lorenzogalli-dev/Reaction-Time-System/Arduino/AlgorithmRealTimeESP32/Data/block_starts_081026/plot_010815_aic_pick.jpeg

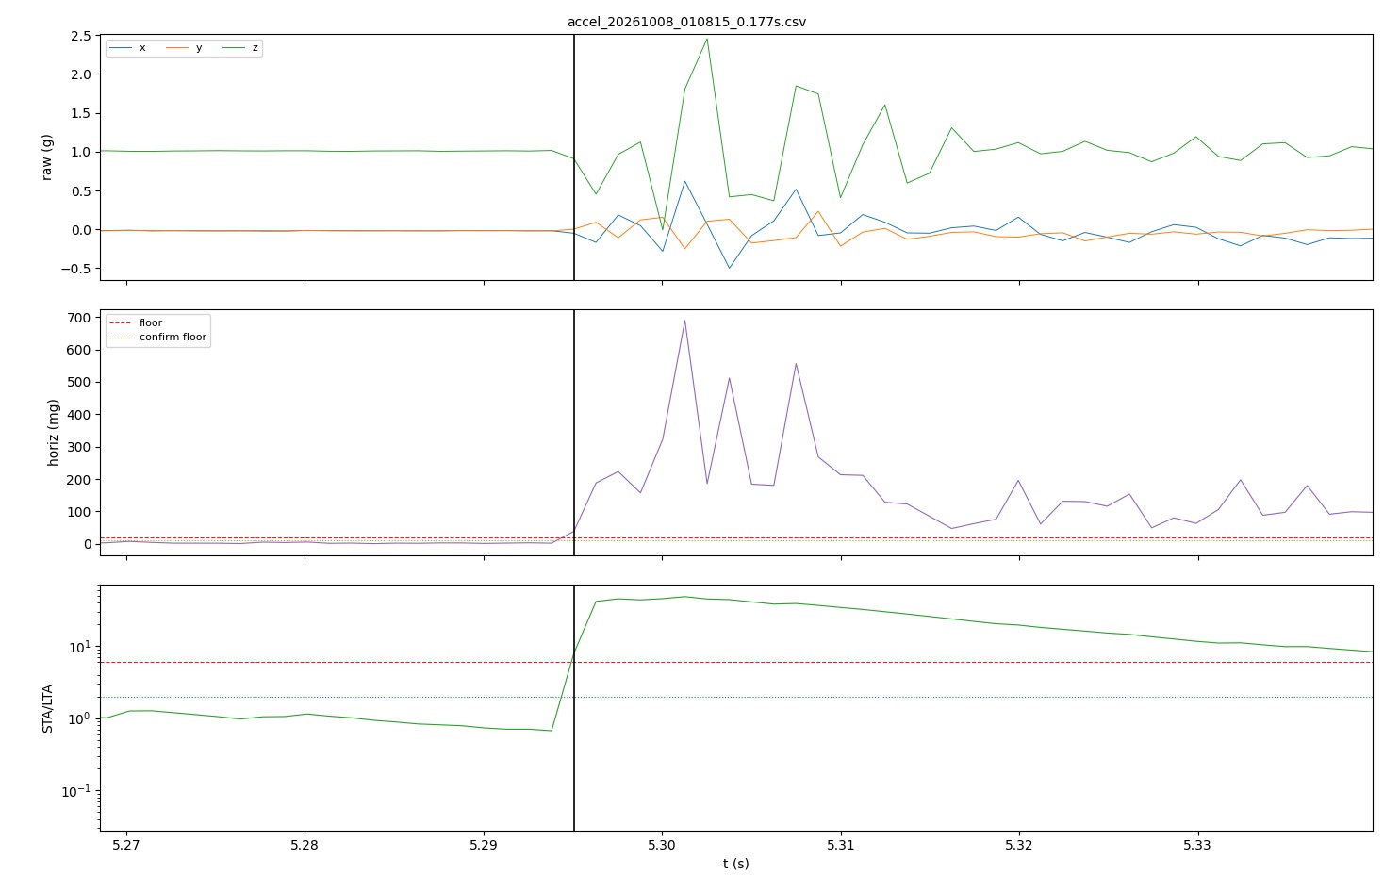
Arduino/AlgorithmRealTimeESP32/Data/block_starts_081026/plot_010815_aic_pick.jpeg
