lorenzogalli-dev/Reaction-Time-System/Arduino/AlgorithmRealTimeESP32/pcb/pcb_3d.jpeg

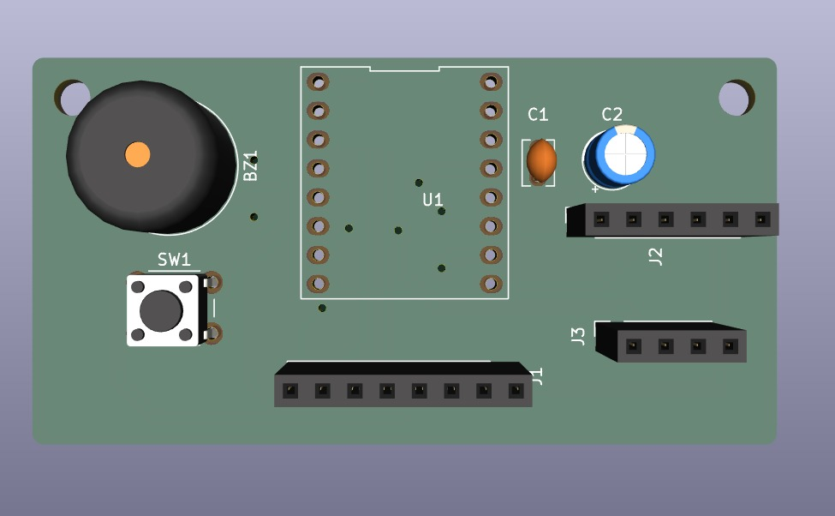
Arduino/AlgorithmRealTimeESP32/pcb/pcb_3d.jpeg
