lorenzogalli-dev/Reaction-Time-System/Arduino/AlgorithmRealTimeESP32/pcb/pcb_layout.jpeg

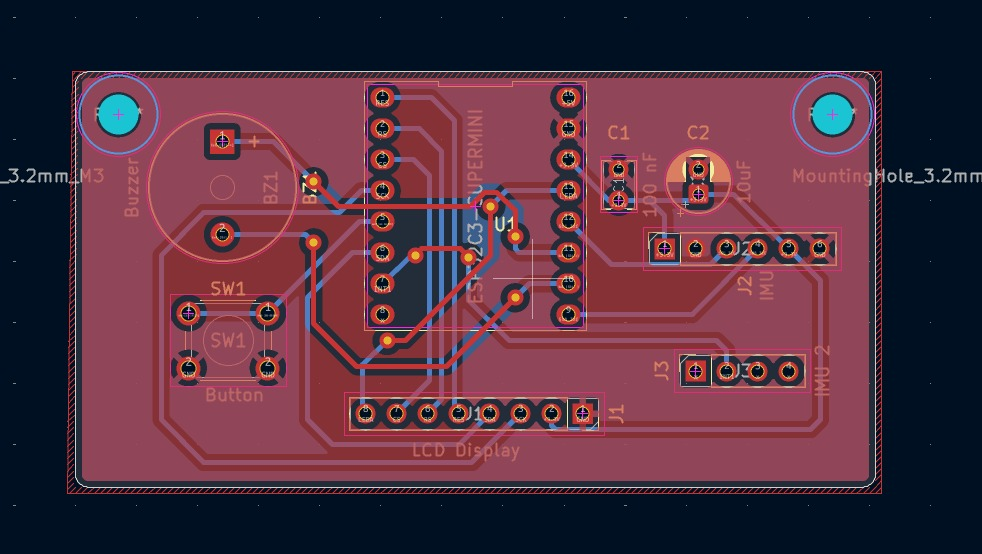
Arduino/AlgorithmRealTimeESP32/pcb/pcb_layout.jpeg
