lorenzogalli-dev/Reaction-Time-System/Arduino/AlgorithmRealTimeESP32/pcb/schematic.jpeg

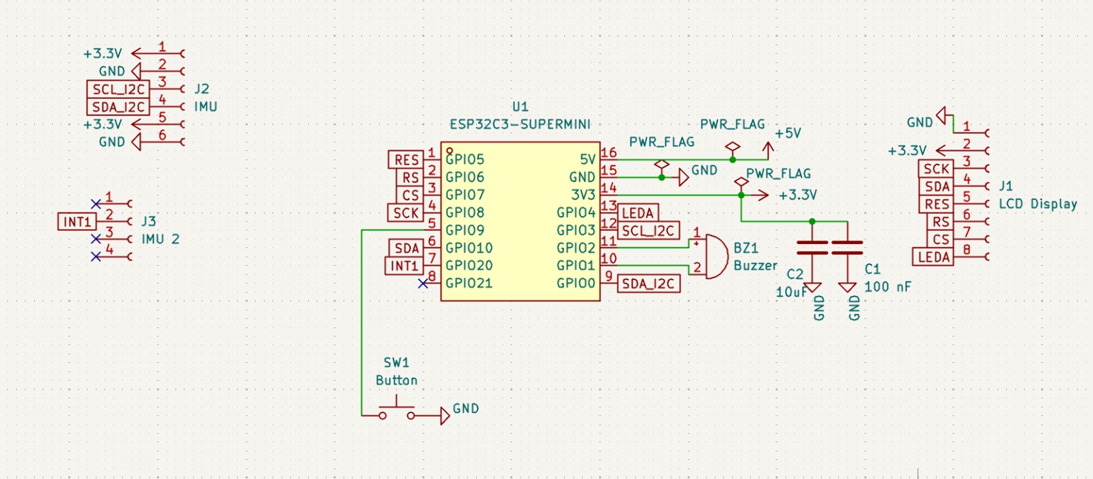
Arduino/AlgorithmRealTimeESP32/pcb/schematic.jpeg
