lorenzogalli-dev/Reaction-Time-System/Data/data_before_080926/accel_20260903_144609.png

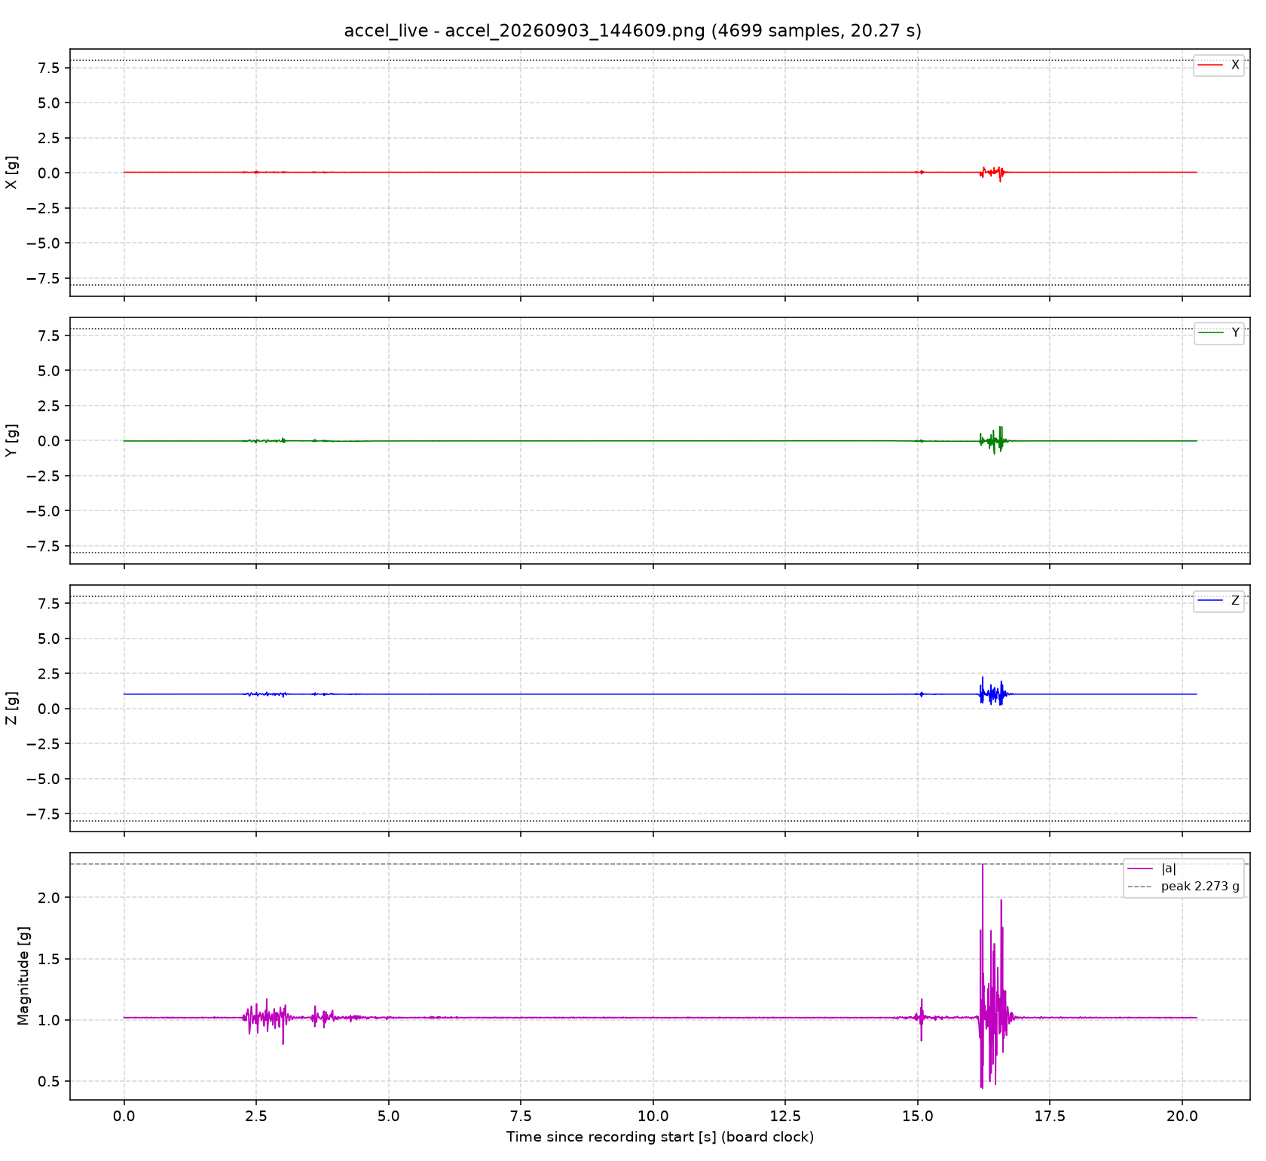
Data/data_before_080926/accel_20260903_144609.png
