lorenzogalli-dev/Reaction-Time-System/Data/data_before_080926/accel_20260907_160755.png

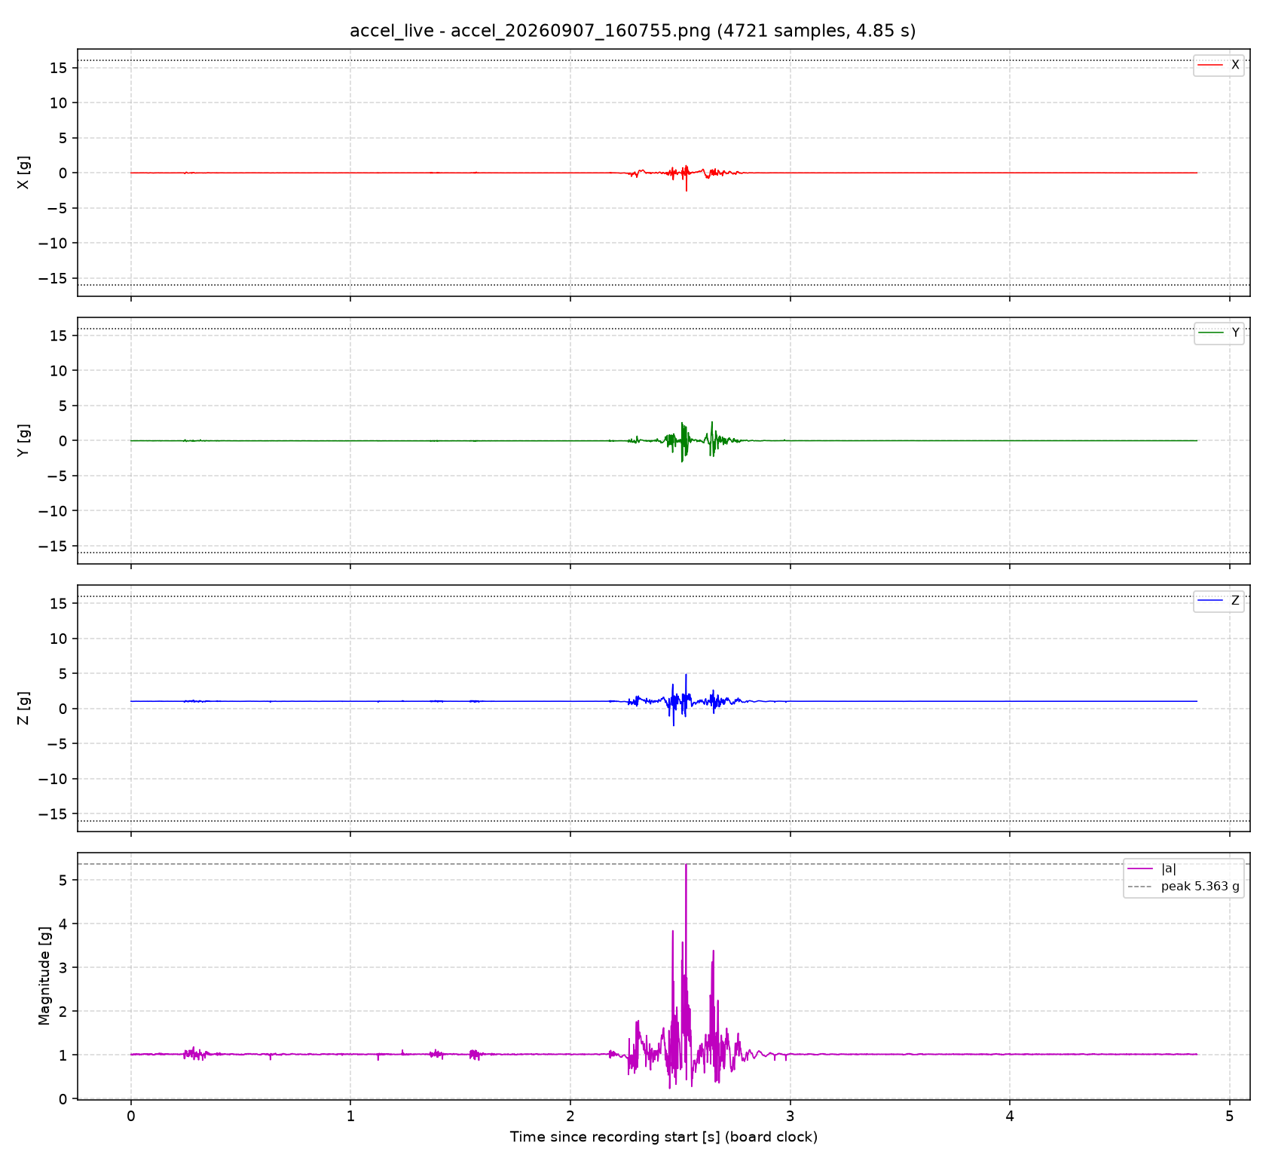
Data/data_before_080926/accel_20260907_160755.png
