lorenzogalli-dev/Reaction-Time-System/Data/data_before_080926/accel_20260908_164231.png

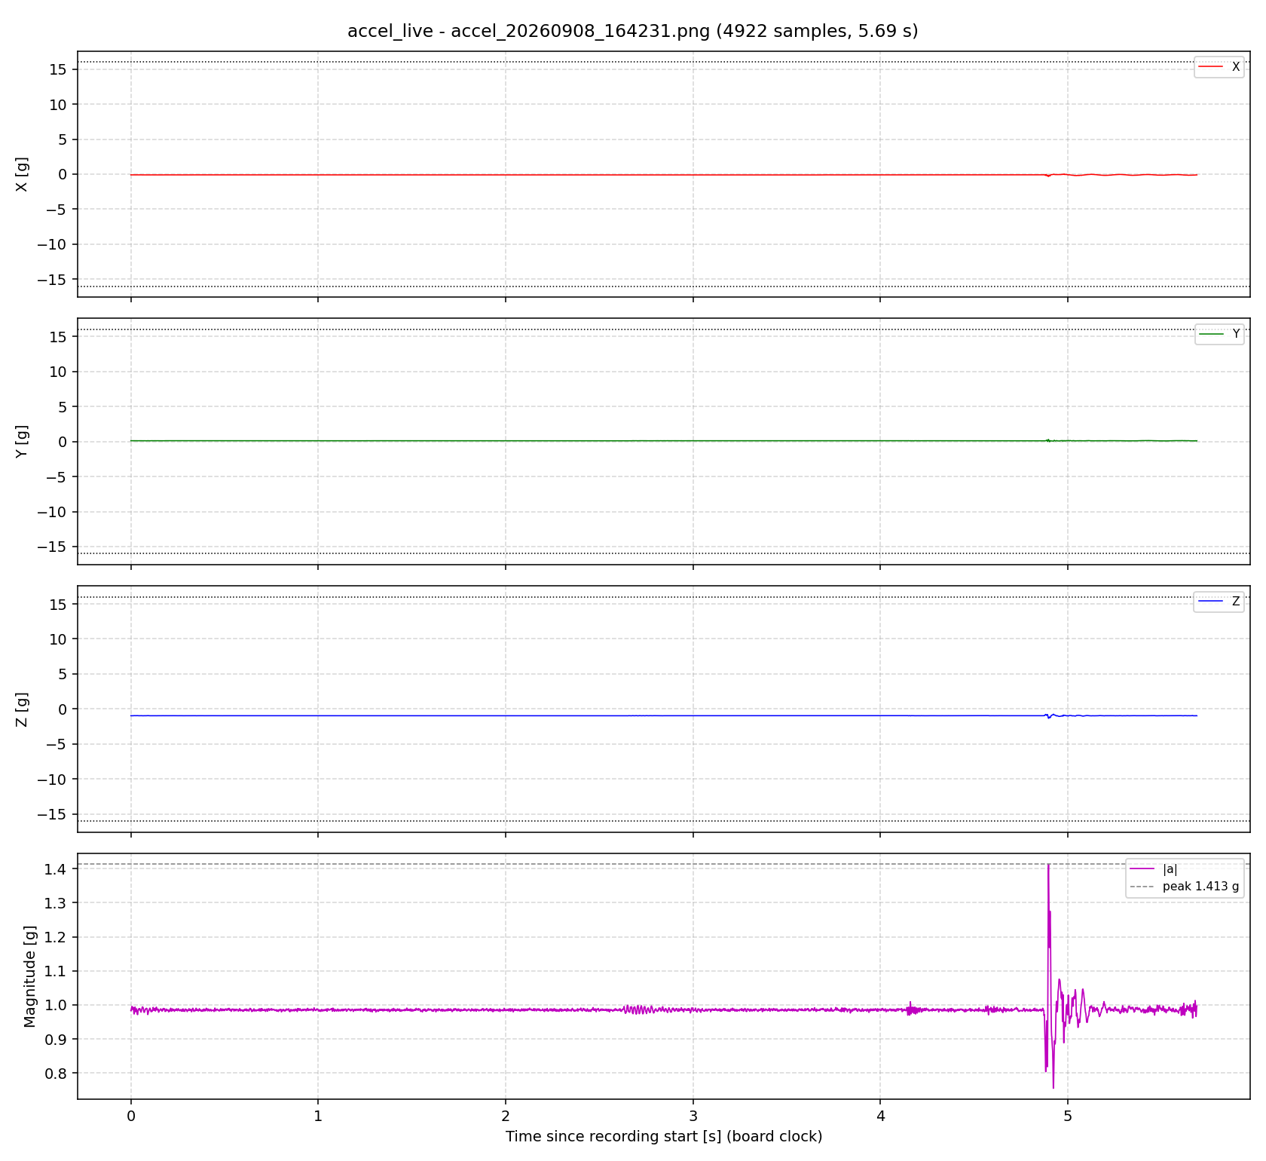
Data/data_before_080926/accel_20260908_164231.png
