lorenzogalli-dev/Reaction-Time-System/Docs/hardware/breadboard_xiao_button_buzzer_before_display.jpg

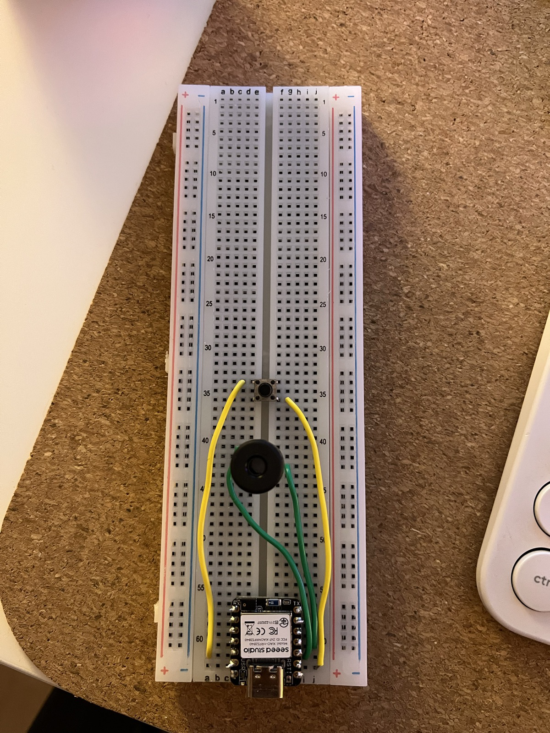
Docs/hardware/breadboard_xiao_button_buzzer_before_display.jpg
