lorenzogalli-dev/Reaction-Time-System/Docs/hardware/tft_177_st7735_back_pinout.jpg

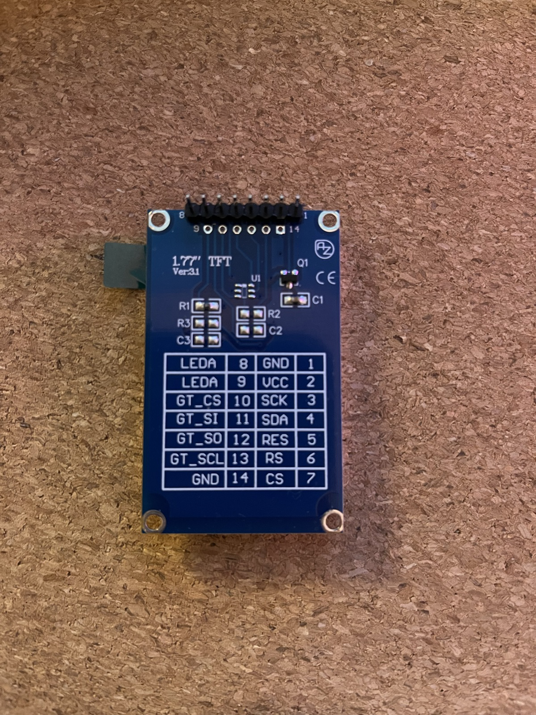
Docs/hardware/tft_177_st7735_back_pinout.jpg
