lorenzogalli-dev/Reaction-Time-System/Docs/hardware/tft_177_st7735_front.jpg

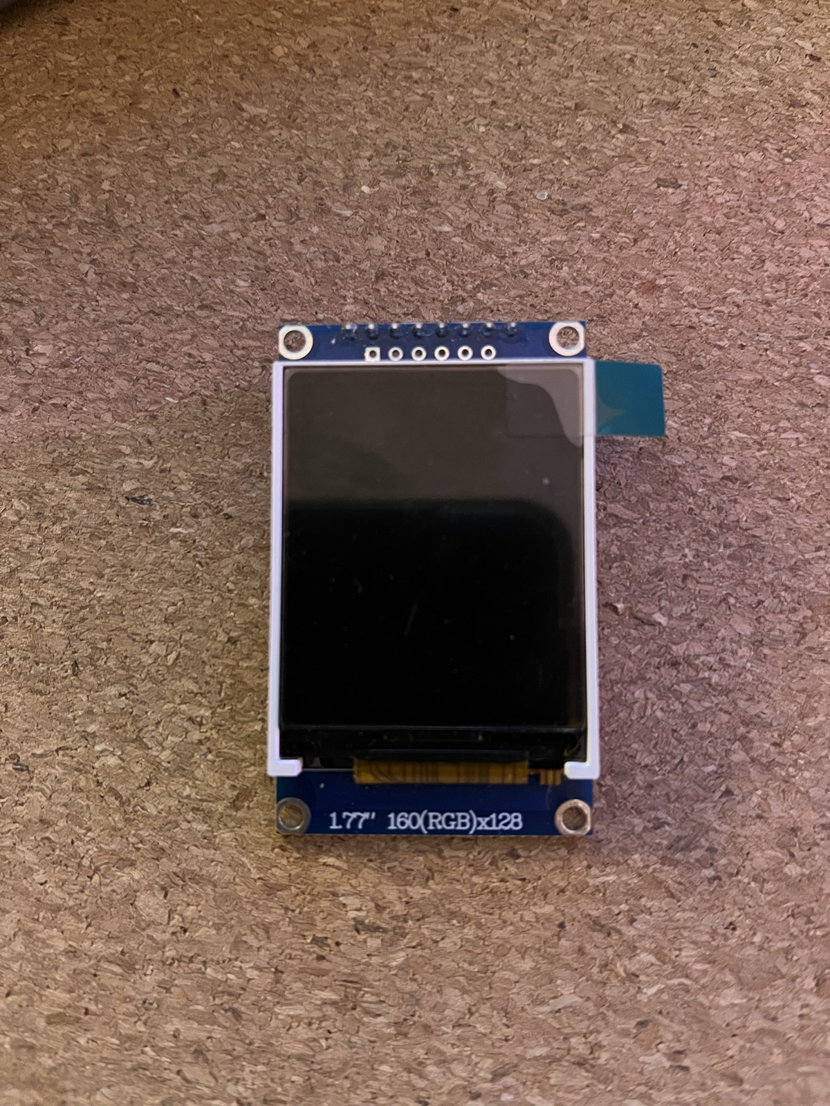
Docs/hardware/tft_177_st7735_front.jpg
