lorenzogalli-dev/Reaction-Time-System/Docs/reaction_time_diagram.png

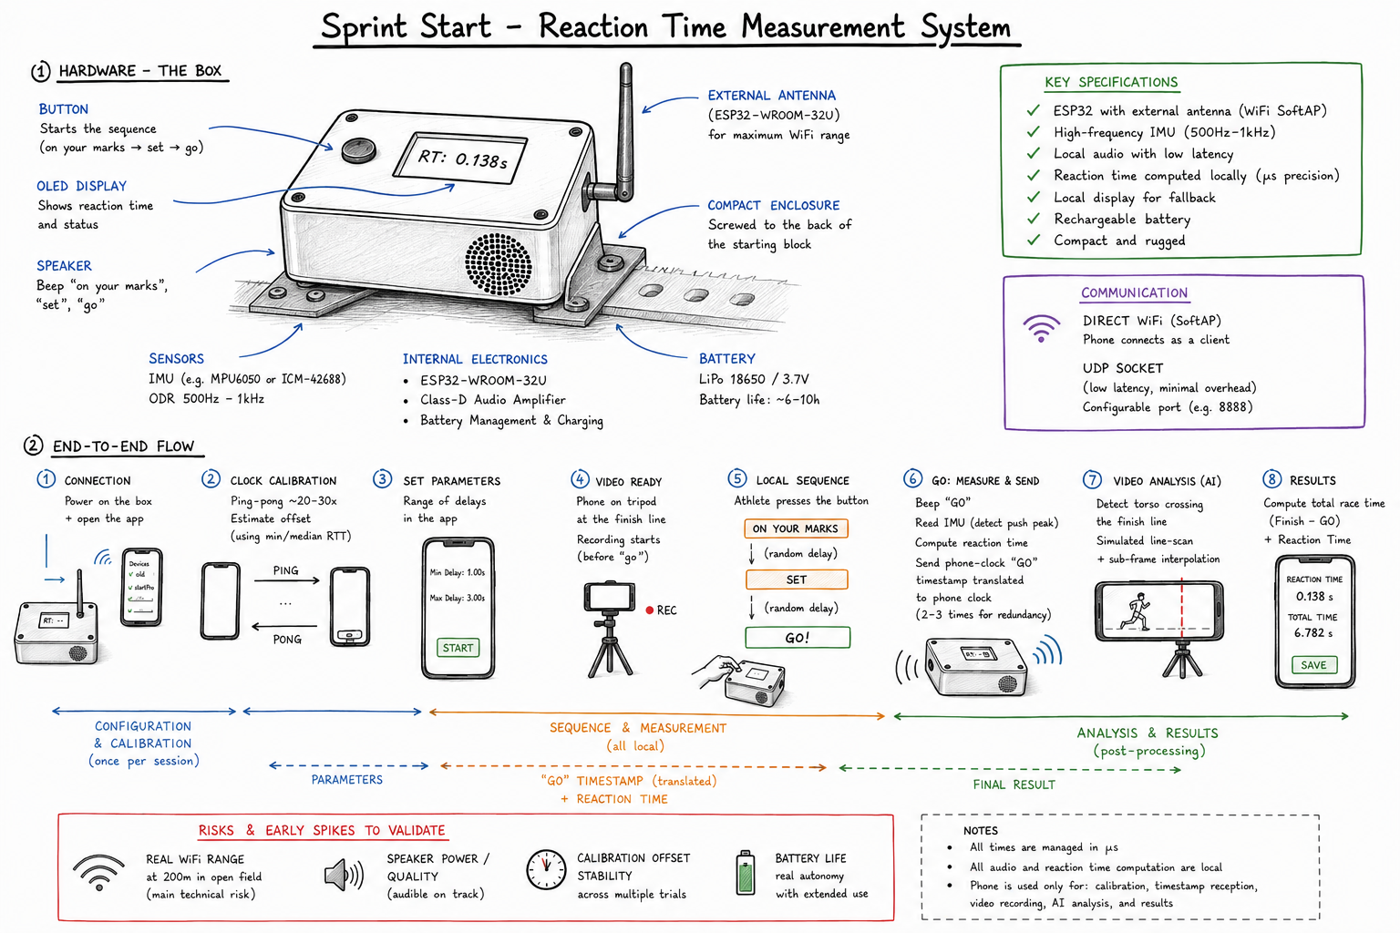
Docs/reaction_time_diagram.png
