lorenzogalli-dev/Reaction-Time-System/Docs/reaction_time_diagram_v2.png

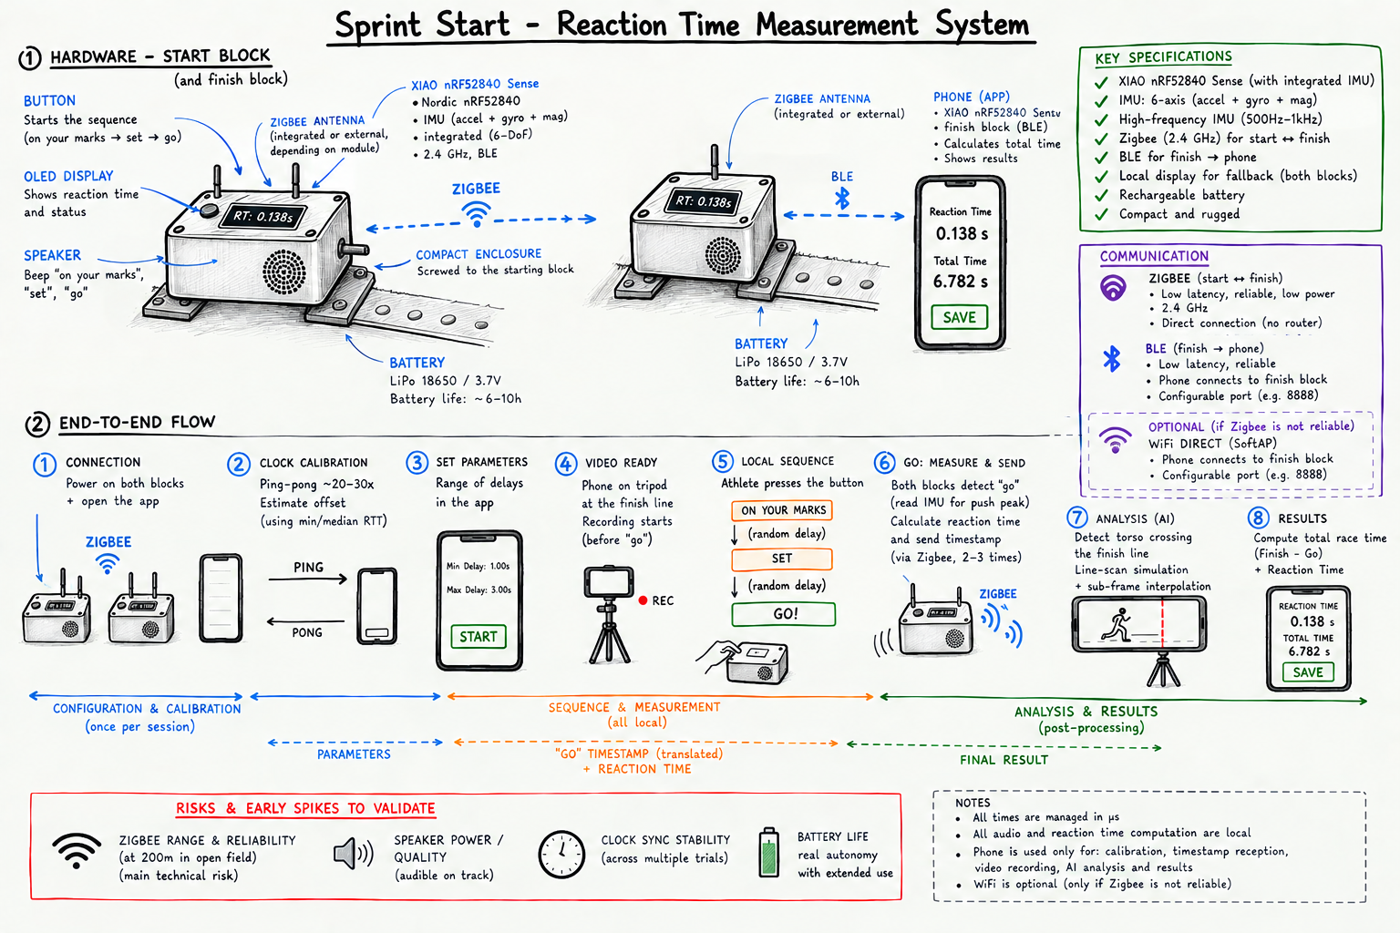
Docs/reaction_time_diagram_v2.png
