lorenzogalli-dev/Reaction-Time-System/prostart/assets/images/finish.png

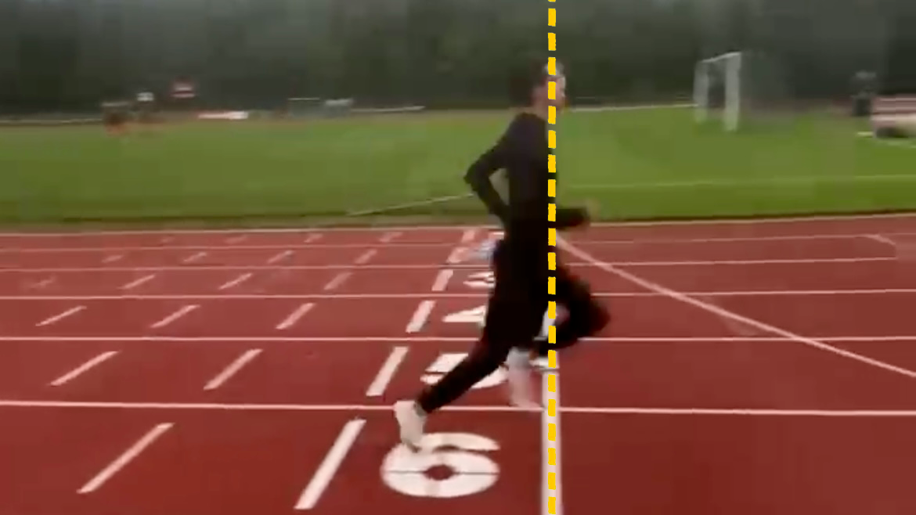
prostart/assets/images/finish.png
