lorenzogalli-dev/Reaction-Time-System/prostart/Prostart Media/56716fc30de684aaa0c9b7536a3d883a.jpg

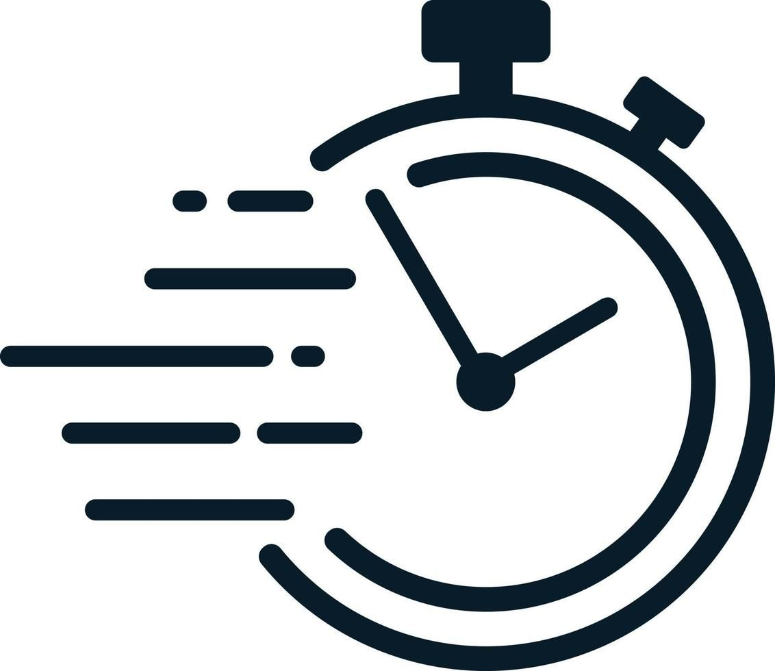
prostart/Prostart Media/56716fc30de684aaa0c9b7536a3d883a.jpg
