lorenzogalli-dev/Reaction-Time-System/prostart/Prostart Media/Box.png

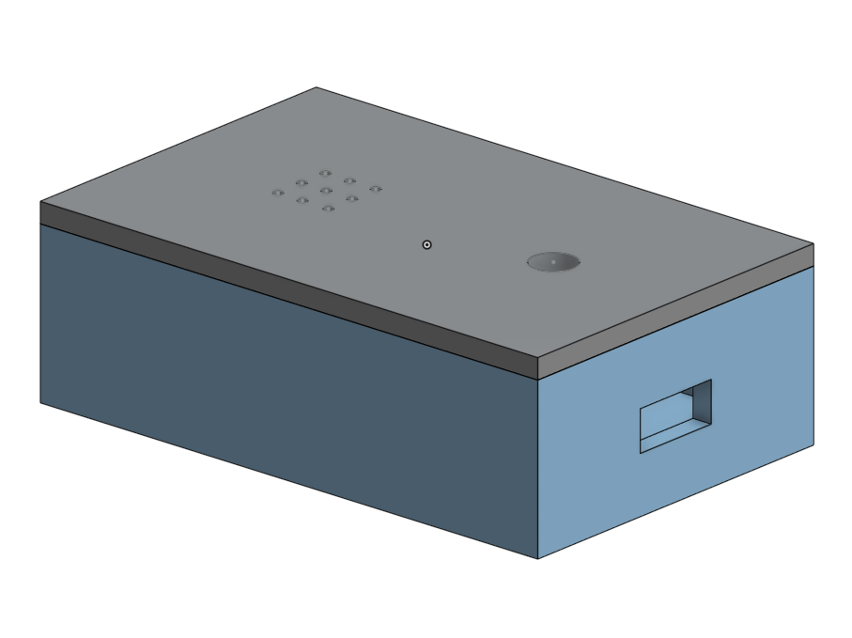
prostart/Prostart Media/Box.png
