lorenzogalli-dev/Reaction-Time-System/prostart/Prostart Media/getstarted.png

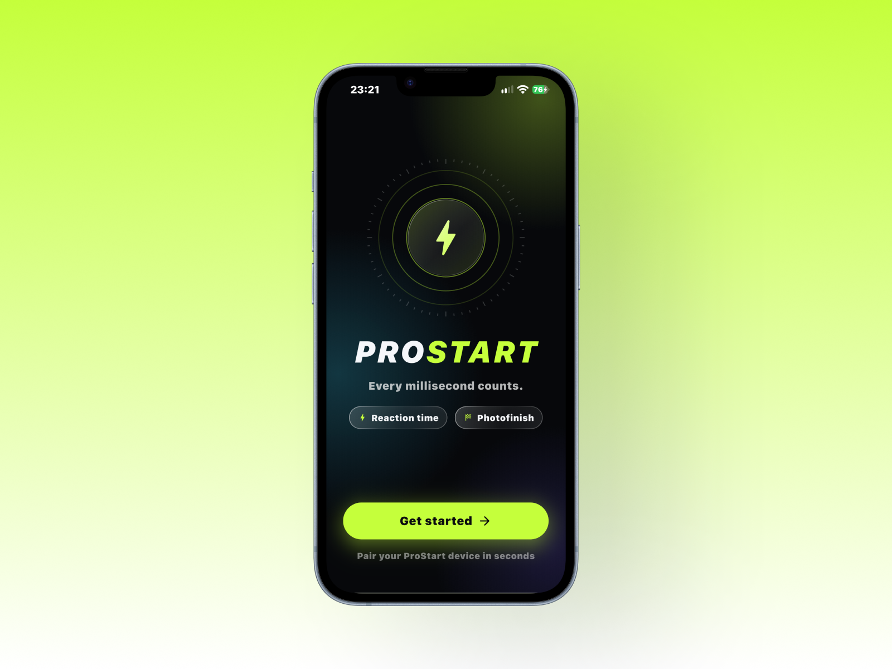
prostart/Prostart Media/getstarted.png
