lorenzogalli-dev/Reaction-Time-System/prostart/Prostart Media/getstartedtransparent.png

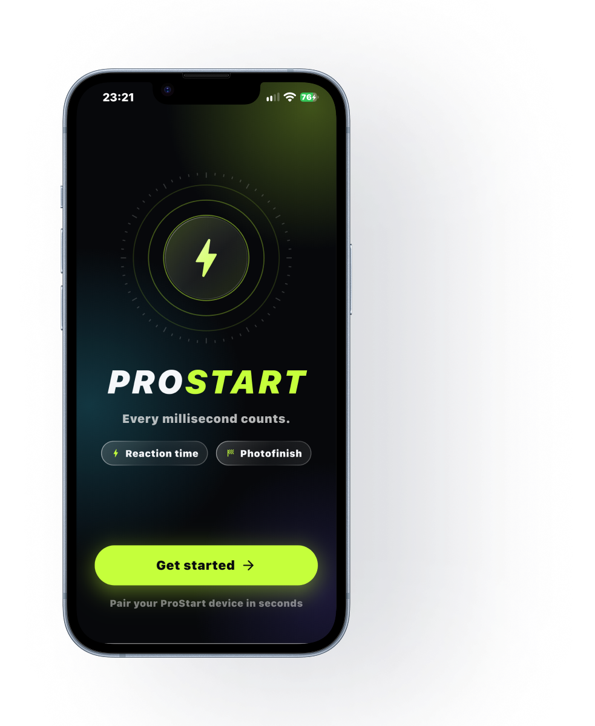
prostart/Prostart Media/getstartedtransparent.png
