lorenzogalli-dev/Reaction-Time-System/prostart/Prostart Media/homepagetransparent.png

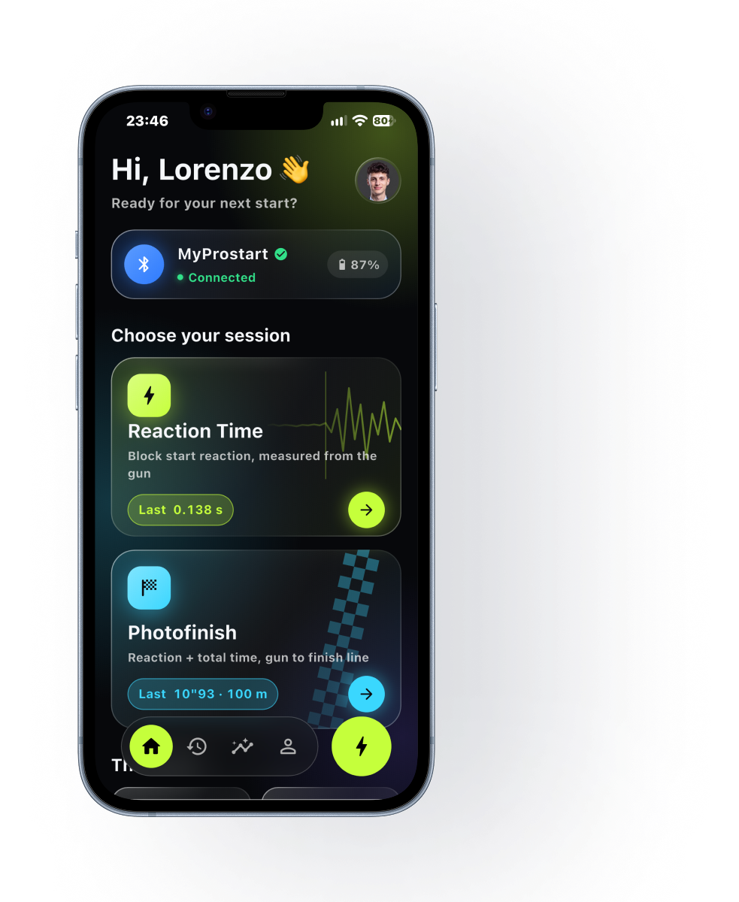
prostart/Prostart Media/homepagetransparent.png
