lorenzogalli-dev/Reaction-Time-System/prostart/Prostart Media/IMG_2231.jpg

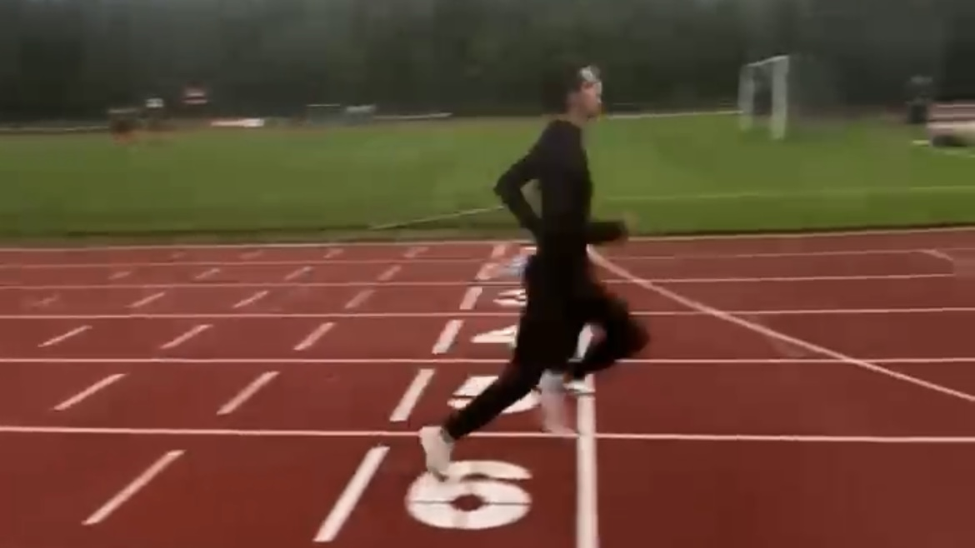
prostart/Prostart Media/IMG_2231.jpg
