lorenzogalli-dev/Reaction-Time-System/prostart/Prostart Media/IMG_2232.PNG

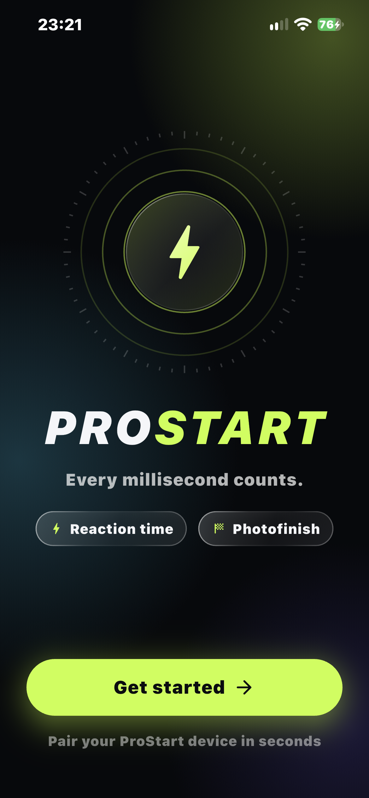
prostart/Prostart Media/IMG_2232.PNG
