lorenzogalli-dev/Reaction-Time-System/prostart/Prostart Media/IMG_2237.PNG

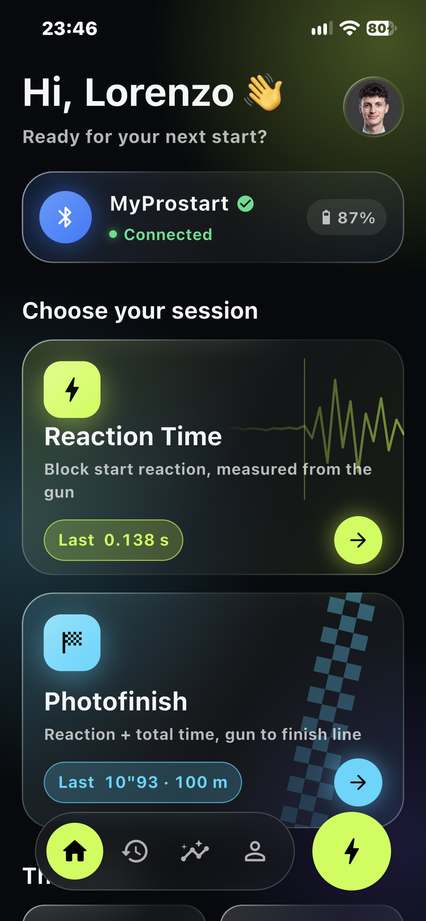
prostart/Prostart Media/IMG_2237.PNG
