lorenzogalli-dev/Reaction-Time-System/prostart/Prostart Media/IMG_2238.PNG

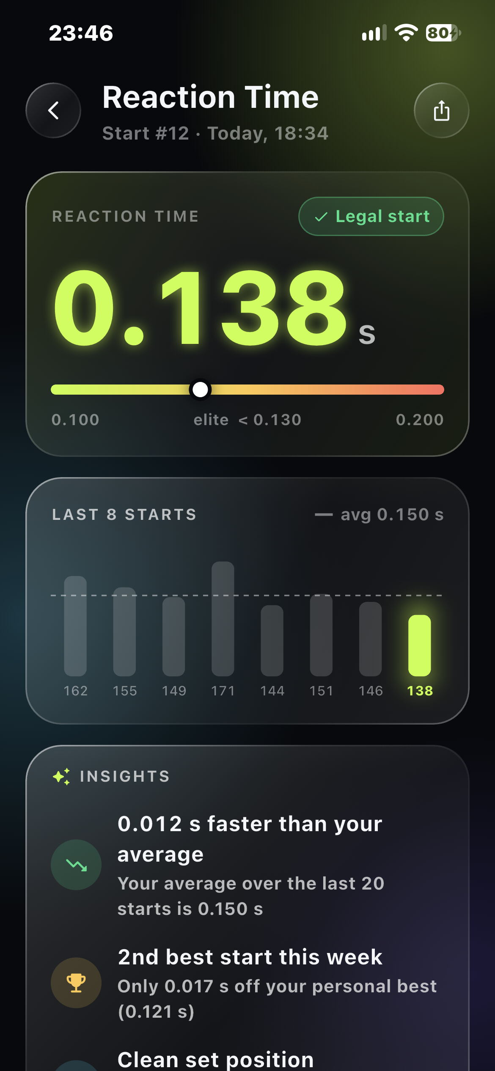
prostart/Prostart Media/IMG_2238.PNG
