lorenzogalli-dev/Reaction-Time-System/prostart/Prostart Media/IMG_2239.PNG

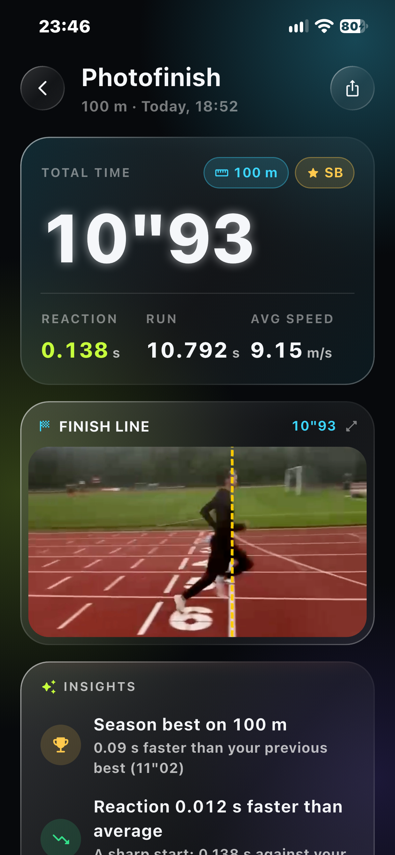
prostart/Prostart Media/IMG_2239.PNG
