lorenzogalli-dev/Reaction-Time-System/prostart/Prostart Media/pages.png

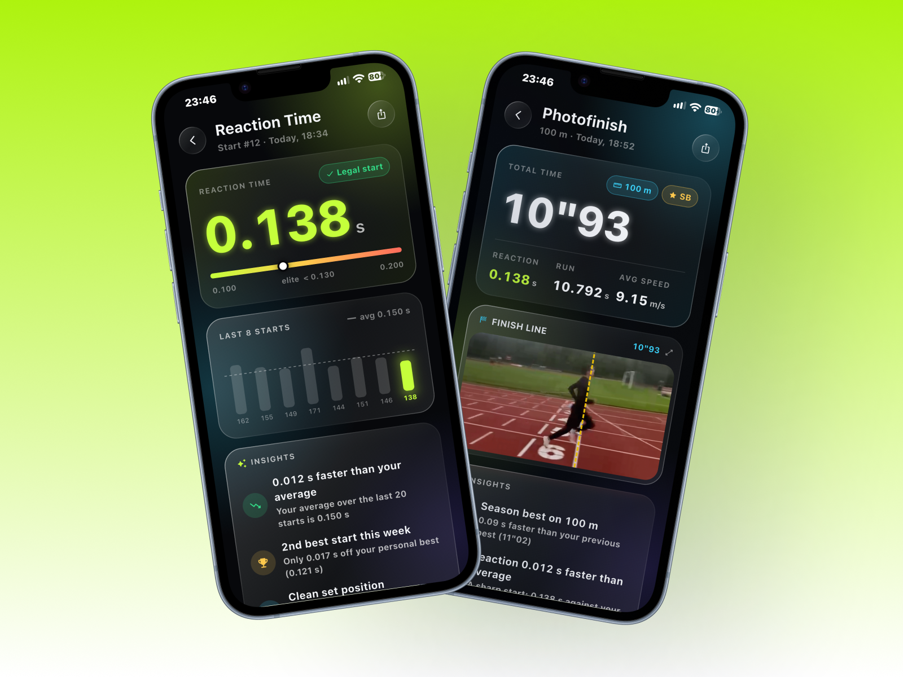
prostart/Prostart Media/pages.png
