lorenzogalli-dev/Reaction-Time-System/prostart/Prostart Media/stopwatch-2.png

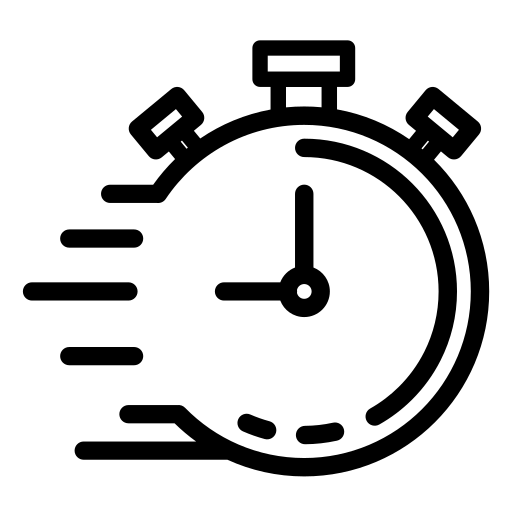
prostart/Prostart Media/stopwatch-2.png
