lorenzogalli-dev/Reaction-Time-System/prostart/Prostart Media/timer.png

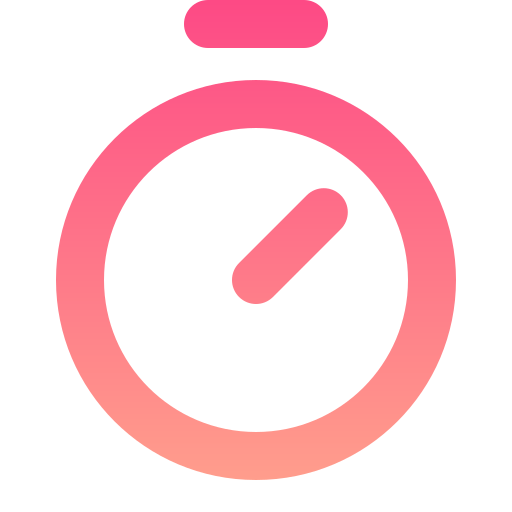
prostart/Prostart Media/timer.png
