lorenzogalli-dev/Reaction-Time-System/Arduino/WifiFieldTest/measurements/20260922/01_rssi-broken.csv

iso | ms | ev | dist | rssi | off | rtt | seq | golat
2026-09-22T12:48:45.410Z | 1790081325409.0 | ping | 0 | 0 | -1790081214054.607 | 4380.00
2026-09-22T12:48:45.410Z | 1790081325409.0 | ping | 0 | 0 | -1790081214054.607 | 4127.00
2026-09-22T12:48:45.410Z | 1790081325409.0 | ping | 0 | 0 | -1790081214054.607 | 3875.00
2026-09-22T12:48:45.410Z | 1790081325409.0 | ping | 0 | 0 | -1790081214054.607 | 3623.00
2026-09-22T12:48:45.410Z | 1790081325409.0 | ping | 0 | 0 | -1790081214054.607 | 3371.00
2026-09-22T12:48:45.410Z | 1790081325409.0 | ping | 0 | 0 | -1790081214054.607 | 3119.00
2026-09-22T12:48:45.410Z | 1790081325409.0 | ping | 0 | 0 | -1790081214054.607 | 2867.00
2026-09-22T12:48:45.493Z | 1790081325492.0 | ping | 0 | 0 | -1790081214054.607 | 10.00
2026-09-22T12:48:45.800Z | 1790081325799.0 | ping | 0 | 0 | -1790081214054.607 | 65.00
2026-09-22T12:48:45.994Z | 1790081325993.0 | ping | 0 | 0 | -1790081214054.607 | 7.00
2026-09-22T12:48:46.022Z | 1790081326021.0 | go | 0 | 0 | -1790081214054.607 |  | 22 | 3.92
2026-09-22T12:48:48.030Z | 1790081328029.0 | ping | 0 | 0 | -1790081214054.607 | 1791.00
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
