lorenzogalli-dev/Reaction-Time-System/Arduino/WifiFieldTest/measurements/20260922/02_short-run-30m.csv

iso | ms | ev | dist | rssi | off | jit | rtt | sent | got | lost | seq | golat
2026-09-22T12:59:45.753Z | 1790081985753.0 | ping | 0 | -48 | -1790081927283.379 | 4.50 | 9.00 | 1 | 1 | 0
2026-09-22T12:59:46.031Z | 1790081986031.0 | ping | 0 | -48 | -1790081927283.379 | 4.50 | 34.00 | 2 | 2 | 0
2026-09-22T12:59:46.271Z | 1790081986271.0 | ping | 0 | -49 | -1790081927283.379 | 4.50 | 22.00 | 3 | 3 | 0
2026-09-22T12:59:46.509Z | 1790081986508.0 | ping | 0 | -49 | -1790081927285.463 | 4.00 | 8.00 | 4 | 4 | 0
2026-09-22T12:59:46.762Z | 1790081986761.0 | ping | 0 | -51 | -1790081927285.463 | 4.00 | 9.00 | 5 | 5 | 0
2026-09-22T12:59:47.016Z | 1790081987015.0 | ping | 0 | -52 | -1790081927285.463 | 4.00 | 11.00 | 6 | 6 | 0
2026-09-22T12:59:47.282Z | 1790081987282.0 | ping | 0 | -53 | -1790081927285.463 | 4.00 | 26.00 | 7 | 7 | 0
2026-09-22T12:59:47.289Z | 1790081987289.0 | go | 0 | -53 | -1790081927285.463 | 4.00 |  | 7 | 7 | 0 | 12 | 2.04
2026-09-22T12:59:47.520Z | 1790081987520.0 | ping | 0 | -55 | -1790081927285.463 | 4.00 | 12.00 | 8 | 8 | 0
2026-09-22T12:59:47.775Z | 1790081987775.0 | ping | 0 | -56 | -1790081927285.463 | 4.00 | 14.00 | 9 | 9 | 0
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
