lorenzogalli-dev/Reaction-Time-System/Arduino/WifiFieldTest/measurements/20260922/03_full-run-70m.csv

iso | ms | ev | dist | rssi | off | jit | rtt | sent | got | lost | seq | golat
2026-09-22T13:00:59.772Z | 1790082059772.0 | ping | 0 | -55 | -1790081927282.724 | 4.00 | 8.00 | 1 | 1 | 0
2026-09-22T13:01:00.033Z | 1790082060033.0 | ping | 0 | -55 | -1790081927282.724 | 4.00 | 17.00 | 2 | 2 | 0
2026-09-22T13:01:00.282Z | 1790082060282.0 | ping | 0 | -55 | -1790081927282.724 | 4.00 | 13.00 | 3 | 3 | 0
2026-09-22T13:01:00.526Z | 1790082060526.0 | ping | 0 | -55 | -1790081927283.422 | 2.50 | 5.00 | 4 | 4 | 0
2026-09-22T13:01:00.780Z | 1790082060780.0 | ping | 0 | -55 | -1790081927283.422 | 2.50 | 7.00 | 5 | 5 | 0
2026-09-22T13:01:01.030Z | 1790082061030.0 | ping | 0 | -55 | -1790081927283.422 | 2.50 | 5.00 | 6 | 6 | 0
2026-09-22T13:01:01.290Z | 1790082061290.0 | ping | 0 | -55 | -1790081927283.422 | 2.50 | 13.00 | 7 | 7 | 0
2026-09-22T13:01:01.535Z | 1790082061535.0 | ping | 0 | -55 | -1790081927283.422 | 2.50 | 6.00 | 8 | 8 | 0
2026-09-22T13:01:01.787Z | 1790082061787.0 | ping | 0 | -54 | -1790081927283.422 | 2.50 | 6.00 | 9 | 9 | 0
2026-09-22T13:01:02.056Z | 1790082062056.0 | ping | 0 | -55 | -1790081927283.422 | 2.50 | 24.00 | 10 | 10 | 0
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
