lorenzogalli-dev/Reaction-Time-System/Arduino/EspNowLrTest/measurements/20260929/01_bench-1m_A.csv

# EspNowLrTest role=A port=/dev/cu.usbmodem101 started=2026-09-29T12:18:38.384802
# host_s | <board line> host_s = seconds since the logger started
0.224 | rst:0x15 (USB_UART_CHIP_RESET) | boot:0xd (SPI_FAST_FLASH_BOOT)
0.224 | Saved PC:0x4038b48a
0.224 | SPIWP:0xee
0.224 | mode:DIO | clock div:1
0.224 | load:0x3fcd5820 | len:0x110c
0.224 | load:0x403cbf10 | len:0xb54
0.224 | load:0x403ce710 | len:0x2f9c
0.224 | entry 0x403cbf10
0.631 | # | EspNowLrTest pronto
0.631 | I | A | 64:E8:33:88:3A:6C | 1 | noap | 20.0
0.631 | I | A | 64:E8:33:88:3A:6C | 1 | noap | 20.0
0.631 | S | 360 | 0 | 0 | 0
0.631 | E | 371 | 0 | 0 | 10571 | 53122695 | -60 | -60
0.631 | E | 374 | 1 | 0 | 13991 | 53124593 | -61 | -59
0.631 | E | 385 | 2 | 0 | 24516 | 53129444 | -61 | -60
0.631 | E | 391 | 3 | 0 | 31158 | 53129944 | -59 | -59
0.631 | E | 398 | 4 | 0 | 37793 | 53133275 | -60 | -59
0.631 | E | 405 | 5 | 0 | 44527 | 53136547 | -60 | -60
0.631 | K | 411 | 0 | 0 | 1 | 51218
0.631 | E | 418 | 6 | 0 | 56997 | 53142852 | -60 | -59
0.631 | E | 421 | 7 | 0 | 11315 | 53123149 | -60 | -59
0.834 | E | 472 | 8 | 0 | 12278 | 53126349 | -60 | -59
0.834 | E | 518 | 9 | 0 | 7682 | 53124028 | -60 | -58
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
