lorenzogalli-dev/Reaction-Time-System/Arduino/EspNowLrTest/measurements/20260929/02_walk-ceramic-antenna_A.csv

# EspNowLrTest role=A port=/dev/cu.usbmodem101 started=2026-09-29T12:51:03.555839
# host_s | <board line> host_s = seconds since the logger started
0.224 | rst:0x15 (USB_UART_CHIP_RESET) | boot:0xd (SPI_FAST_FLASH_BOOT)
0.224 | Saved PC:0x420b4b04
0.224 | SPIWP:0xee
0.224 | mode:DIO | clock div:1
0.224 | load:0x3fcd5820 | len:0x110c
0.224 | load:0x403cbf10 | len:0xb54
0.224 | load:0x403ce710 | len:0x2f9c
0.224 | entry 0x403cbf10
0.631 | # | EspNowLrTest pronto
0.631 | I | A | 64:E8:33:88:3A:6C | 1 | noap | 20.0
0.631 | I | A | 64:E8:33:88:3A:6C | 1 | noap | 20.0
0.631 | S | 362 | 0 | 0 | 0
0.631 | E | 370 | 0 | 0 | 8152 | 610071186 | -40 | -39
0.631 | E | 399 | 2 | 0 | 37328 | 610069891 | -41 | -40
0.631 | E | 403 | 3 | 0 | 40695 | 610071563 | -41 | -40
0.631 | E | 406 | 4 | 0 | 44109 | 610073167 | -42 | -41
0.631 | E | 409 | 5 | 0 | 47442 | 610074813 | -41 | -42
0.631 | K | 413 | 0 | 0 | 1 | 50912
0.631 | E | 420 | 7 | 0 | 8678 | 610071544 | -39 | -40
0.833 | E | 471 | 8 | 0 | 8964 | 610071594 | -40 | -39
0.833 | E | 519 | 9 | 0 | 7666 | 610070944 | -39 | -39
0.833 | E | 569 | 10 | 0 | 7871 | 610071077 | -40 | -40
0.833 | E | 620 | 11 | 0 | 8123 | 610071199 | -43 | -43
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
