lorenzogalli-dev/Reaction-Time-System/Arduino/EspNowLrTest/measurements/20260929/02_walk-ceramic-antenna_B.csv

# EspNowLrTest role=B port=COM15 started=2026-09-29T12:51:13.930742
# host_s | <board line> host_s = seconds since the logger started
0.234 | I | B | 64:E8:33:88:16:00 | 1 | noap | 20.0
0.234 | D | 619735 | 192 | 1 | -44 | 26
0.234 | D | 619785 | 193 | 1 | -44 | 26
0.234 | D | 619835 | 194 | 1 | -43 | 26
0.234 | D | 619885 | 195 | 1 | -43 | 26
0.234 | D | 619935 | 196 | 1 | -44 | 26
0.437 | D | 619985 | 197 | 1 | -45 | 26
0.437 | D | 620041 | 198 | 1 | -44 | 26
0.437 | D | 620088 | 199 | 1 | -45 | 26
0.437 | D | 620134 | 200 | 2 | -43 | 0
0.437 | T | 620135 | 2 | 1 | 2 | -44
0.640 | D | 620186 | 201 | 2 | -43 | 0
0.640 | D | 620234 | 202 | 2 | -44 | 0
0.640 | D | 620284 | 203 | 2 | -43 | 0
0.640 | D | 620335 | 204 | 2 | -43 | 0
0.843 | D | 620385 | 205 | 2 | -43 | 0
0.843 | D | 620434 | 206 | 2 | -44 | 0
0.843 | D | 620484 | 207 | 2 | -44 | 0
0.843 | D | 620534 | 208 | 2 | -44 | 0
1.046 | D | 620584 | 209 | 2 | -43 | 0
1.046 | D | 620634 | 210 | 2 | -43 | 0
1.046 | D | 620685 | 211 | 2 | -43 | 0
1.046 | D | 620734 | 212 | 2 | -44 | 0
1.250 | D | 620784 | 213 | 2 | -43 | 0
1.250 | D | 620834 | 214 | 2 | -45 | 0
1.250 | D | 620884 | 215 | 2 | -44 | 0
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
