lorenzogalli-dev/Reaction-Time-System/Arduino/EspNowLrTest/measurements/20260929/03_track-walk-31mm-wire_A.csv

# EspNowLrTest role=A port=/dev/cu.usbmodem101 started=2026-09-29T15:14:36.186668
# host_s | <board line> host_s = seconds since the logger started
0.223 | Build:Feb 7 2021
0.223 | rst:0x15 (USB_UART_CHIP_RESET) | boot:0xf (SPI_FAST_FLASH_BOOT)
0.223 | Saved PC:0x403870c6
0.223 | SPIWP:0xee
0.223 | mode:DIO | clock div:1
0.223 | load:0x3fcd5820 | len:0x110c
0.223 | load:0x403cbf10 | len:0xb54
0.223 | load:0x403ce710 | len:0x2f9c
0.223 | entry 0x403cbf10
0.627 | # | EspNowLrTest pronto
0.627 | I | A | 64:E8:33:88:3A:6C | 1 | noap | 20.0
0.627 | I | A | 64:E8:33:88:3A:6C | 1 | noap | 20.0
0.627 | S | 359 | 0 | 0 | 0
0.627 | E | 373 | 0 | 0 | 13606 | 219783039 | -40 | -40
0.627 | E | 379 | 1 | 0 | 20282 | 219783055 | -41 | -40
0.627 | E | 386 | 2 | 0 | 26982 | 219782974 | -41 | -43
0.627 | E | 393 | 3 | 0 | 33545 | 219786391 | -40 | -39
0.627 | E | 399 | 4 | 0 | 40224 | 219789697 | -40 | -40
0.627 | E | 406 | 5 | 0 | 47108 | 219792878 | -39 | -39
0.627 | E | 410 | 6 | 0 | 50616 | 219797790 | -40 | -41
0.828 | E | 466 | 8 | 0 | 7645 | 219785891 | -39 | -39
0.829 | E | 516 | 9 | 0 | 7677 | 219785898 | -40 | -39
0.829 | E | 566 | 10 | 0 | 7709 | 219785912 | -40 | -39
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
