lorenzogalli-dev/Reaction-Time-System/Arduino/EspNowLrTest/measurements/20260929/03_track-walk-31mm-wire_B.csv

# EspNowLrTest role=B port=COM15 started=2026-09-29T15:13:58.672149
# host_s | <board line> host_s = seconds since the logger started
0.234 | I | B | 64:E8:33:88:16:00 | 1 | noap | 20.0
0.234 | D | 181180 | 1000 | 1 | -47 | 26
0.234 | T | 181182 | 10 | 1 | 1 | -47
0.234 | D | 181230 | 1001 | 1 | -47 | 26
0.234 | D | 181280 | 1002 | 1 | -47 | 26
0.234 | D | 181330 | 1003 | 1 | -47 | 26
0.437 | D | 181380 | 1004 | 1 | -47 | 26
0.437 | D | 181430 | 1005 | 1 | -47 | 26
0.437 | D | 181480 | 1006 | 1 | -47 | 26
0.437 | D | 181530 | 1007 | 1 | -47 | 26
0.640 | D | 181580 | 1008 | 1 | -47 | 26
0.640 | D | 181630 | 1009 | 1 | -47 | 26
0.640 | D | 181680 | 1010 | 1 | -47 | 26
0.640 | D | 181730 | 1011 | 1 | -47 | 26
0.640 | D | 181780 | 1012 | 1 | -47 | 26
0.843 | D | 181830 | 1013 | 1 | -48 | 26
0.843 | D | 181880 | 1014 | 1 | -47 | 26
0.843 | D | 181930 | 1015 | 1 | -48 | 26
0.843 | D | 181980 | 1016 | 1 | -47 | 26
1.046 | D | 182030 | 1017 | 1 | -47 | 26
1.078 | D | 182080 | 1018 | 1 | -47 | 26
1.078 | D | 182130 | 1019 | 1 | -47 | 26
1.078 | D | 182180 | 1020 | 1 | -48 | 26
1.281 | D | 182230 | 1021 | 1 | -47 | 26
1.281 | D | 182280 | 1022 | 1 | -47 | 26
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
