lorenzogalli-dev/Reaction-Time-System/Arduino/EspNowLrTest/measurements/20260929/04_110m-crouched-phone-B2m_A.csv

# EspNowLrTest role=A port=/dev/cu.usbmodem101 started=2026-09-29T15:48:25.524223
# host_s | <board line> host_s = seconds since the logger started
0.224 | rst:0x15 (USB_UART_CHIP_RESET) | boot:0xf (SPI_FAST_FLASH_BOOT)
0.224 | Saved PC:0x40388006
0.224 | SPIWP:0xee
0.224 | mode:DIO | clock div:1
0.224 | load:0x3fcd5820 | len:0x110c
0.224 | load:0x403cbf10 | len:0xb54
0.224 | load:0x403ce710 | len:0x2f9c
0.224 | entry 0x403cbf10
0.627 | # | EspNowLrTest pronto
0.628 | I | A | 64:E8:33:88:3A:6C | 1 | noap | 20.0
0.628 | I | A | 64:E8:33:88:3A:6C | 1 | noap | 20.0
0.628 | S | 350 | 0 | 0 | 0
0.628 | E | 364 | 0 | 0 | 13441 | 123494063 | -32 | -32
0.628 | E | 367 | 1 | 0 | 17391 | 123495527 | -32 | -32
0.628 | E | 374 | 2 | 0 | 23615 | 123495705 | -32 | -32
0.628 | E | 381 | 3 | 0 | 30689 | 123502616 | -32 | -32
0.628 | E | 387 | 4 | 0 | 37037 | 123506152 | -31 | -33
0.628 | E | 395 | 5 | 0 | 43940 | 123509325 | -32 | -33
0.628 | E | 402 | 6 | 0 | 51633 | 123512140 | -33 | -33
0.628 | K | 408 | 0 | 0 | 1 | 58322
0.628 | E | 412 | 7 | 0 | 12696 | 123496836 | -31 | -33
0.831 | E | 457 | 8 | 0 | 7716 | 123496934 | -32 | -32
0.832 | E | 507 | 9 | 0 | 7853 | 123497005 | -31 | -32
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
