lorenzogalli-dev/Reaction-Time-System/Arduino/EspNowLrTest/EspNowLrTest/EspNowLrTest.ino

// Tutto il codice sta in app.cpp, incluse setup() e loop().
//
// Stesso motivo di WifiFieldTest: il preprocessore .ino di Arduino genera i
// prototipi con ctags, che su questo Mac non funziona bene. Un .cpp viene
// compilato cosi' com'e'.
