lorenzogalli-dev/Reaction-Time-System/(commit log)

2026-08-28 Add IMU test sketches
2026-08-28 Add BLE test firmware and Flutter app with real BLE connect/scan flow
2026-08-29 Fix IMU init timing on XIAO Sense (add startup delay before myIMU.begin())
2026-08-29 Add live IMU data view, move device connection to Settings
    App:
    - Home screen now only reflects connection status: a prompt pointing at
    Settings when disconnected, a "See Live Data" entry point when connected.
    The connect card/sheet moved to the new Settings tab.
    - New live data screen: 50 Hz accelerometer chart, Record button buffering
    timestamped samples in memory, per-axis min/max/average, and CSV export
    through the platform share sheet (share_plus + path_provider).
    - The chart is a CustomPainter repainting off the vsync ticker rather than a
    charting package, which rebuilds the widget tree per update and gets janky
    at 50 Hz. Samples arrive through a ValueNotifier so the data r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
2026-08-29 Fix unbounded Serial wait in I2C_Scanner, correct README paths
    Three follow-ups from HANDOFF.md that needed no hardware:
    - I2C_Scanner.ino had the same `while (!Serial)` trap already fixed in
    BLEtest.ino: on the XIAO's native USB, Serial only goes true when a host
    opens the CDC port, so setup() blocks forever on battery or on a charger.
    Now the same bounded 3 s wait.
    - Wire prostartAccelerometerSampleRateHz into the recording summary, which
    now reads "48.7 Hz (nominal 50 Hz)" so the achieved rate can be checked
    against the firmware's target on screen.
    - README repository structure listed firmware/ and app/; the real layout is
    Arduino/ and prostart/. Getting Started paths correct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
    [I2C_Scanner.ino]
2026-08-29 Fix CSV export on iOS by pinning path_provider_foundation to 2.5.1
    Exporting a recording failed at getTemporaryDirectory() with:
    Failed to load dynamic library 'objective_c.framework/objective_c'
    path_provider_foundation 2.5.0 replaced its iOS/macOS plugin with an
    objective_c FFI backend, 2.5.1 reverted it, and 2.6.0 (what the lockfile
    resolved to) went back to FFI. That backend ships as a Flutter code asset,
    which is only built and embedded into Runner.app when native assets are
    enabled - and `flutter config` reports enable-native-assets as not set on
    stable. So the framework was never produced and dlopen found nothing in
    Runner.app/Frameworks.
    The tell was ios/Podfile.lock: the FFI ve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
2026-08-29 Add IMU evaluation for false-start detection
    Analysis of a real 14 s accelerometer capture from the prototype, to decide
    whether the LSM6DS3 can support false-start detection and reaction time.
    Findings:
    - The sensor is not the constraint. Noise floor is 0.65 mg (1σ); a light
    finger tap peaks at 196 mg, 300× the noise, and a real block push-off is
    1-3 g. A 20 mg threshold sits ~30σ clear of the noise. Resting magnitude
    is 0.991 g, so accelRange and the library scaling agree.
    - The BLE stream's timestamps cannot be used for timing. Arrival intervals
    are bimodal with the nominal 20 ms bin empty: 30% of samples arrive with
    no measurable gap from the previous one, the rest cluste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
    [prostart_imu_20260829_213017.csv]
2026-08-29 Add system overview diagram to the README
    Hand-drawn overview of the whole system: the starting-block box and its
    internals, and the eight-step end-to-end flow from pairing and clock
    calibration through the local start sequence to video analysis and results.
    Placed near the top of the README, and the repository structure updated for
    the new docs/ folder and playground_IMU/.
2026-08-29 Align HANDOFF with the current state of the work
    The doc had drifted: it still described the README's old firmware/ and app/
    layout as broken, flagged the I2C_Scanner Serial trap as unfixed, claimed a
    build-artifact directory was tracked (only build.gradle.kts is, and that is a
    source file), and referenced pre-rewrite commit hashes.
    Updated throughout, and extended to cover the second piece of work:
    - Scope widened to include the sensor evaluation, with a pointer to
    playground_IMU/ and the findings that bear on firmware: raise the ODR to
    416/833 Hz for the detection path, trigger on horizontal-plane magnitude
    rather than |a|, threshold ~20 mg, and calibrate the speaker's audio
    late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
2026-08-31 Added CSV folder
    [kinestart_imu_20260831_182831.csv, kinestart_imu_20260831_183116.csv, kinestart_imu_20260831_183438.csv, kinestart_imu_20260831_183700.csv, prostart_imu_20260829_213017.csv]
2026-08-31 Added more CSVs
    [kinestart_imu_20260831_185529.csv, kinestart_imu_20260831_190343.csv]
2026-08-31 Block starts data
    [Block_Start_Data.csv]
2026-09-01 Reorganized IMU data into data directory
    [kinestart_imu_20260831_182831.csv, kinestart_imu_20260831_183116.csv, kinestart_imu_20260831_183438.csv, kinestart_imu_20260831_183700.csv, kinestart_imu_20260831_185529.csv, kinestart_imu_20260831_190343.csv, prostart_imu_20260829_213017.csv]
2026-09-01 Added new Arduino Code and Python file for visualization and Export CSV via Serial
    [kinestart_imu_20260901_134341.csv]
2026-09-01 CSV visualizer on Arduino
2026-09-02 Aggiornato firmware BLEtest con streaming IMU ad alta frequenza
2026-09-02 Firmware: cattura seriale ad alta frequenza con timestamp misurati
    Aggiunge una modalita' di streaming CSV sulla seriale ('r' avvia, 's' ferma:
    le stesse lettere che manda gia' lo script Python esistente), pensata per
    caratterizzare il sensore sul banco dove il BLE non arriva - 833 Hz in
    continuo invece di dump da 2.4 s.
    L'elapsed di ogni riga e' accumulato dai delta fra sampleTimeUs() consecutivi,
    cioe' dai timestamp del PLL agganciato alla FIFO, non da un contatore
    moltiplicato per il periodo nominale: deriva dell'oscillatore e buchi restano
    visibili nei dati invece di essere nascosti dall'asse dei tempi.
    Le scritture non bloccano mai: se il buffer di uscita e' pieno si riprova al
    giro d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
2026-09-02 App: il timestamp dei campioni live viene dal dispositivo
    Il payload della caratteristica 19B10002 passa da 12 a 16 byte: uint32 t_us
    piu' i tre float degli assi. L'istante e' quello di cattura sul clock micros()
    della board, non quello di arrivo sul telefono.
    Serve perche' il BLE consegna i campioni a raffiche - nella cattura del
    2026-08-31 gruppi di 1-4 insieme, con gap di 29-31 ms fra i gruppi - quindi
    un timestamp preso all'arrivo porta +/-15-30 ms di errore contro un target di
    1-2 ms.
    Allineato a Arduino/BLEtest/BLEtest.ino.
2026-09-02 Aggiunto tools/kinestart_live.py: interfaccia live, registrazione ed export
    Vista in tempo reale di X/Y/Z e magnitudine, con pulsanti per registrare,
    fermare ed esportare (o i tasti r/s/p). Il CSV viene scritto riga per riga
    durante la registrazione, non alla fine, cosi' una prova interrotta a meta'
    lascia comunque su disco quello che ha catturato; allo stop salva anche un PNG
    dell'intera registrazione.
    Le colonne di tempo t_s e device_elapsed_s vengono dal clock della board.
    C'e' anche host_iso, l'ora di arrivo sul computer, marcata esplicitamente
    nell'intestazione del file come non utilizzabile per misurare: e' l'errore che
    aveva viziato le catture del 2026-08-31.
    Mostra durante la prova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
2026-09-04 Nuova pipeline accelerometro senza BLE dopo crash-loop di BLEtest.ino
    BLEtest.ino (FIFO 833 Hz + PLL + BLE) si blocca o va in crash-loop in modo
    riproducibile su due board XIAO diverse; uno sketch minimo senza IMU/BLE
    (Arduino/SerialEchoTest) funziona su entrambe, quindi il problema e' nel
    firmware, non nell'hardware - causa non isolata, BLEtest.ino lasciato
    invariato (solo commenti tradotti in inglese, nessuna modifica funzionale).
    Arduino/AccelStream/AccelStream.ino sostituisce il capture path: niente
    BLE, niente FIFO hardware, sole letture dirette LSM6DS3 a 416 Hz con
    timestamp micros() reale per campione (non un modello nominale/PLL),
    fondo scala +/-8 g per evitare clipping su una vera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
    [accel_20260903_143300.csv, accel_20260903_144609.csv, kinestart_imu_20260831_182831.csv, kinestart_imu_20260831_183116.csv, kinestart_imu_20260831_183438.csv, kinestart_imu_20260831_183700.csv, kinestart_imu_20260831_185529.csv, kinestart_imu_20260831_190343.csv]
2026-09-04 Riorganizzazione repo, nuovo README/BUILD e diagramma v2
    Pulizia cartelle: eliminato firmware rotto (Arduino/BLEtest,
    Arduino/HighFrequencySampleRate) e tool superati (tools/kinestart_live.py),
    rimosso playground_IMU; rinominate data/tools/docs in Data/Tools/Docs,
    prostart spostato dentro "Flutter App/". Aggiornati tutti i riferimenti
    incrociati (README, HANDOFF, script Python, .gitignore).
    README.md riscritto: nuova architettura a due XIAO nRF52840 (start + finish)
    collegati via Zigbee invece del Wi-Fi (scartato per UX), sezione business
    plan con costi/prezzo/tier freemium e proiezione ricavi illustrativa,
    rimossa la vecchia architettura ASCII (ridondante col diagramma), roadmap
    ora punta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
    [accel_20260903_143300.csv, accel_20260903_144609.csv, blockstart_20260831_test0.csv]
2026-09-07 im not sure, sry
    [kinestart_imu_20260903_113851.csv, kinestart_imu_20260903_131112.csv]
2026-09-07 Firmware v2: burst I2C, 977Hz reale, marker o/s/g/S; algoritmo detection offline
    AccelStream.ino: lettura X/Y/Z in una sola transazione I2C invece di sei
    (causa del tetto di 232Hz misurato prima), ODR sensore a 1660Hz (977-979Hz
    la resa reale, limitata dall'overhead per-transazione I2C sulla nRF52840),
    range +/-16g, protocollo cambiato da streaming continuo a buffer-poi-scarico
    (niente stampa seriale durante la registrazione, solo al dump finale) per
    non far mai competere la seriale col campionamento. Aggiunti marker o/s/g/S
    (attenti/pronti/via/stop) timestampati sull'orologio del firmware stesso,
    zero dipendenza da audio o sincronizzazione col PC.
    accel_live.py riscritto per il nuovo proto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
    [accel_20260907_155406.csv, accel_20260907_160108.csv, accel_20260907_160354.csv, accel_20260907_160755.csv]
2026-09-08 Firmware v3: campionamento a 833 Hz guidato dall'interrupt data-ready (INT1)
    v2 configurava 1660 Hz e ne otteneva ~977. Non era un fallback del sensore:
    il chip girava davvero a 1660 Hz, ma una burst read costa ~1023 us contro un
    budget di 602, quindi la scadenza del pacing non era mai raggiungibile e il
    loop girava libero al throughput dell'I2C. Il rate era ripetibile
    (977.5-978.5 Hz) ma emergente - e' quello che avanza dopo il carico del loop,
    quindi aggiungere il detector STA/LTA on-device lo avrebbe abbassato in
    silenzio, lo stesso fallimento che aveva bloccato v1 a 232 Hz.
    Ora il ritmo lo detta la linea data-ready del sensore su INT1 (pin 18 sul
    XIAO nRF52840 Sense): 833 Hz fissi, con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
2026-09-08 Fix: risolvi il pin INT1 anche sul core mbed, non solo su Seeeduino:nrf52
    La guardia introdotta con v3 bocciava la compilazione sulle voci "No Updates"
    (core Seeeduino:mbed 2.9.3) pur avendo selezionato una XIAO nRF52840 Sense
    corretta. La board non c'entrava: quel core definisce PIN_LSM6DS3TR_C_INT1 in
    pins_arduino.h e non lo include tramite Arduino.h, mentre Seeeduino:nrf52
    1.1.13 lo rende gia' visibile. Stessa scheda, stesso pin 18, solo non ancora
    dichiarato. Ora lo si include quando manca, invece di rifiutare una board
    perfettamente capace, e il messaggio dell'#error non manda piu' a cambiare
    scheda quando la scheda e' giusta.
    Questo copre anche un bug preesistente sullo stesso core: P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
    [AccelStream.ino]
2026-09-08 verify_rate: allinea a v3 e correggi il comando di stop
    - --target-hz da 1660 a 833: confrontava con un target che il firmware non
    ha mai raggiunto nemmeno in v2 (~977 Hz reali), quindi su una board sana
    stampava FAIL.
    - lo stop mandava 's', che nel firmware e' il marker "set" e non ferma
    niente: la registrazione finiva solo quando il buffer si riempiva, quindi
    --seconds veniva ignorato in silenzio e ogni cattura durava sempre un
    buffer intero. Ora manda 'S', che ferma e scarica davvero.
    - legge e verifica la riga DROPPED del dump invece di scartarla come riga
    inattesa: un valore diverso da zero significa che il watchdog data-ready
    ha dovuto recuperare campioni, quindi quei tim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
    [verify_rate.py]
2026-09-08 Fix: togli micros() dall'ISR, il timestamp torna nel loop principale
    Regressione introdotta con v3 e vista subito al primo test su hardware: i dt
    registrati collassavano su due soli valori, 977 us e 1954 us (= 2x977), cioe'
    una griglia da 1/1024 s. Le catture di v2 che questa modifica sostituiva
    avevano 59 valori distinti di dt intorno a 1022 us, quindi la risoluzione
    fine c'era ed e' stata persa.
    Causa: micros() chiamato in contesto di interrupt su questo core non ha
    risoluzione a microsecondi, ricade su un contatore a 1024 Hz. Prendere il
    timestamp nell'ISR - il presunto guadagno di v3 - lo leggeva esattamente dove
    quell'orologio non funziona.
    Ora l'ISR alza solo il flag e il timestamp s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
    [AccelStream.ino, verify_rate.py]
2026-09-08 ClockCheck: sketch diagnostico che misura la risoluzione reale di micros()
    Due diagnosi sbagliate di fila sulla granularita' dei timestamp (prima
    attribuita alla chiamata di micros() dentro l'ISR, poi al core mbed) senza
    mai misurare nulla sulla board. Questo sketch chiude la questione: dichiara
    quale core e' stato effettivamente compilato (__MBED__) e misura il passo
    minimo osservabile di micros() su 200k letture.
    Un passo di 1-2 us significa clock a 1 MHz vero; ~977 us significa che sotto
    c'e' una griglia a 1024 Hz, che e' quello che i dt bimodali 977/1954 us del
    test su hardware suggeriscono.
    Compila su entrambi i core (nrf52 richiede Adafruit_TinyUSB esplicito per
    Serial, che AccelStre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
2026-09-08 Misura la risoluzione di micros() al boot e la riporta in ogni cattura
    La granularita' dei timestamp non dipende dallo sketch ma da quale core lo
    compila, in silenzio:
    - Seeeduino:mbed -> mbed::Timer, contatore vero a 1 MHz (~1 us)
    - Seeeduino:nrf52 -> DWT solo se abilitato, altrimenti ripiega sul tick
    FreeRTOS, e configTICK_RATE_HZ vale 1024 -> passi da 976.5625 us
    Senza debugger attaccato il DWT e' spento, quindi sul core nrf52 il caso
    normale e' quello degradato. Un test su hardware l'ha mostrato: intervalli tra
    campioni ridotti a due soli valori, 977 us e 1954 us, con DROPPED=0, zero gap
    e accelerazioni sensate. Dati che sembrano buoni e non lo sono - il modo
    peggiore di sbagli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
2026-09-08 Doc: allinea BUILD.md e HANDOFF.md a v3 e al vincolo sul core
    BUILD.md mandava dritti nel muro: indicava il core Seeeduino:nrf52, che e'
    esattamente quello con micros() a 976 us, e dichiarava ancora 416 Hz e un
    protocollo seriale di due tasti. Ora la sezione firmware apre con la tabella
    dei due core e il perche', documenta 833 Hz nominali / ~863 reali via
    interrupt INT1, il banner corrente, l'intero protocollo o/s/g/S/r/p, e mette
    verify_rate.py come passo 7 obbligatorio dopo il flash. Aggiunti anche
    detect_pushoff.py e verify_rate.py alla sezione tooling, che citava solo
    accel_live e csv_plot.
    HANDOFF.md: nuova sezione in testa sul 2026-09-08, con la causa radice citata
    dal sorgente del co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
2026-09-08 Firmware v4: la sequenza di start la genera la board, non piu' un dito
    Fino alla v3 il marker "go" era una pressione di tasto umana relayata via
    seriale, quindi il riferimento era peggio della cosa misurata: su
    Data/accel_20260907_160108.csv cade ~90 ms DOPO il movimento che doveva
    marcare. Tarare una soglia da +/-10 ms contro un riferimento da +/-100 ms
    non ha senso.
    Ora un pulsante avvia una sequenza randomizzata e il firmware suona i tre
    beep da solo, timestampandoli con lo stesso micros() di ogni campione:
    pulsante -> 2-3 s -> "on your marks" -> 20-25 s -> "set"
    -> 2.2-3 s -> "go" -> 1 s -> dump
    Resta solo la latenza acustica del buzzer (5-20 ms), sistematica quindi
    calib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
    [AccelStream.ino]
2026-09-08 Tooling: da cinque script a tre, e il detector prende due stadi
    Tools/ aveva due detector e due visualizzatori che si sovrapponevano, e
    non era piu' ovvio quale fosse quello buono. Ora:
    capture.py scrive su CSV quello che la board dumpa. Nient'altro.
    start_detector.py rilevamento onset e falsa partenza, GUI e CLI
    verify_rate.py pass/fail su clock, rate e integrita'
    capture.py e' deliberatamente stupido: non tiene stato di registrazione e
    non prende decisioni di timing, quindi non puo' corromperne. Tutta
    l'autorita' sul tempo e' passata al firmware, ed e' li' che deve restare.
    start_detector.py e' l'interfaccia di sta_lta_start_detector.py (che era
    la cosa giusta: tarare si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
    [capture.py, start_detector.py, verify_rate.py]
2026-09-08 Dati e documentazione: archivio pre-v4, INFO.md, e le prime catture v4
    Data/ ora contiene solo catture v4. Tutto quello che precede la sera del
    2026-09-08 e' in Data/data_before_080926/, con un README che spiega
    perche' sono separate: il loro marker "go" e' una pressione di tasto
    umana, +/-100 ms. I dati restano validi per verificare il meccanismo, ma
    tarare le soglie contro quel riferimento sarebbe circolare. Non hanno
    nemmeno pre-roll, quindi il detector e' cieco nei primi ~800 ms.
    Quattro catture nuove del 2026-09-08 sera, le prime con il "go" generato
    dal firmware:
    232806 controllo negativo, sensore fermo: nessun evento, horiz max
    6.5 mg nella finestra giudicata
    233329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
    [accel_20260903_143300.csv, accel_20260903_144609.csv, accel_20260907_155406.csv, accel_20260907_160108.csv, accel_20260907_160354.csv, accel_20260907_160755.csv, accel_20260908_164231.csv, accel_20260908_232806.csv]
2026-09-09 Buzzer passivo con tone(), set->go accorciato a 10-15s, pannello sinistro scrollabile
    Il buzzer ora e' pilotato con tone()/noTone() invece di digitalWrite,
    necessario per un trasduttore passivo (nessun oscillatore interno).
    Latenza di tone() e suo effetto sul timing dei campioni DRDY ancora
    da verificare su questo core.
    Il ritardo set->go passa da 20-25s a 10-15s. Nel tool di rilevamento,
    il pannello parametri a sinistra ora scorre con Canvas+Scrollbar
    invece di essere tagliato quando il contenuto supera l'altezza della
    finestra.
    Aggiunte le catture del 2026-09-09, rimosse quelle obsolete del giorno
    precedente.
    [accel_20260908_232806.csv, accel_20260908_233329.csv, accel_20260908_233722.csv, accel_20260908_235147.csv, accel_20260909_115803.csv, accel_20260909_121238.csv, accel_20260909_122226.csv, accel_20260909_122543.csv]
2026-09-13 Buzzer: 4 kHz di risonanza, pilotaggio antifase con PWM hardware
    Il beep era troppo debole per essere usato in pista. Uno sweep in
    frequenza (Arduino/BuzzerSweep, nuovo) identifica il componente come un
    piezo con risonanza netta a 4000 Hz: alzando il drive del pad nRF52840
    da 0.5 a 5 mA non cambia nulla, quindi non e' un magnetico pilotato in
    corrente. BEEP_FREQ_HZ passa da 3000 a 4000, cioe' da un numero tondo a
    una misura.
    Il pilotaggio diventa antifase su D1/D2 (niente piu' collegamento a
    massa): l'elemento vede 6.6 Vpp invece di 3.3, +6 dB senza componenti
    aggiuntivi. E' sicuro perche' un piezo e' un condensatore e non passa
    continua - su un magnetico da 16 ohm non lo sarebbe.
    tone() v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
    [AccelStream.ino, BuzzerSweep.ino]
2026-09-14 Arm the start on measured stillness instead of a fixed blanking
    The detector used to wait a flat 1000 ms after "set" and then start judging,
    and "go" fired at set + random(2.2-3.0 s) without ever looking at the athlete.
    Measured over the 27 block starts in Data/, settling into the set position runs
    to 2.65 s after "set" and varies from 1.0 s to 3.3 s between attempts, so a
    clock cannot know when it is over. The consequence was concrete: 16 of the 19
    09-09 captures reported NOT JUDGEABLE while every one of them contained a
    perfectly good reaction time.
    The firmware now holds for DET_MIN_BLANK_MS, waits for the horizontal signal to
    stay under DET_SETTLED_MG for DET_QUIET_HOLD_MS continuously,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
    [accel_20260909_115803.csv, accel_20260909_121238.csv, accel_20260909_122226.csv, accel_20260909_122543.csv, accel_20260909_123455.csv, accel_20260909_123532.csv, accel_20260909_124515.csv, accel_20260909_125004.csv]
2026-09-15 Archive the pre-arming-gate detector, land the 140926 block-start captures, fix capture.py's outdir
    old_python_algorithm/start_detector.py is the last version before 7927ead's
    arm-on-stillness rewrite (fixed 1000 ms blanking, no ARM marker) - kept for
    reference now that the algorithm it describes is gone from the live tree.
    The 45 captures from 2026-09-14 were an on-block test of the finished gate
    (40 valid starts, median 147.0 ms; 5 false starts) but capture.py's relative
    "Data" default wrote them into Python_Tools/Data instead of the top-level
    Data/ every other capture lives in. Moved them to Data/block_starts_140926/
    and pointed capture.py's default outdir at the repo root so it can't ha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
    [accel_20260914_171838.csv, accel_20260914_172357.csv, accel_20260914_175304.csv, accel_20260914_175500.csv, accel_20260914_175935.csv, accel_20260914_180334.csv, accel_20260914_180809.csv, accel_20260914_180905.csv]
2026-09-17 Land the 150926 block-start captures
    11 attempts, 2026-09-15, same athlete and gate as block_starts_140926.
    All 11 valid starts (median 150.5 ms, range 119.3-213.4 ms).
    [accel_20260915_174559.csv, accel_20260915_174828.csv, accel_20260915_174911.csv, accel_20260915_182906.csv, accel_20260915_183435.csv, accel_20260915_184023.csv, accel_20260915_184702.csv, accel_20260915_185751.csv]
2026-09-22 Measure the Wi-Fi t0 link in the field: 60-70 m, against 100 m required
    Replaces Arduino/WifiRangeTest (written, never compiled) with
    Arduino/WifiFieldTest: one ESP32-C3 sketch that serves its own measuring
    page to the phone, so a walk down the track produces RSSI, RTT, loss,
    reconnects, clock offset and t0 delivery in one CSV.
    The link carries the t0 for the photofinish, not the reaction time, so
    latency is free and only arrival and clock alignment matter. Measured:
    clean to ~50 m, dead at 70 m at -91 dBm, ~21 dB/decade. 100 m needs 3-4 dB
    more. Sync jitter 2.5-4 ms against 9.6 ms sd from a 30 fps frame, so the
    camera is the bottleneck, not the radio.
    The first run is kept as a record of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
    [01_rssi-broken.csv, 02_short-run-30m.csv, 03_full-run-70m.csv]
2026-09-22 Check the paper against the data, and make the threshold sweep reproducible
    The evaluation section's numbers were re-derived from Data/ rather than
    trusted. The primary result holds; several numbers around it were true of
    one session written as if true of all four (45 starts, medians, the 29 ms
    threshold spread), and the four captures with no event turn out to include
    a real start lost to a micros() wrap.
    sweep_threshold.py prints the sweep tables and writes Docs/threshold_sweep.pdf
    in one run, closing the open item carried since 09-21.
2026-09-24 Rename Flutter App to Old Flutter App: prostart/ is the app from now on
    The root prostart/ becomes the app under development. The old one stays for
    its BLE layer, which the new app will need once it stops using mock data.
    README, BUILD, .gitignore and HANDOFF point at the new layout, and
    prostart/README.md replaces the flutter create template.
    [main.cpp]
2026-09-24 README: the ESP-NOW long-range architecture, the new image, and the half-time paper
    The system is now XIAO wired to an ESP32, ESP-NOW long range to a second
    ESP32 at the finish, BLE to the phone. README's overview, hardware, stack,
    BOM and open risks follow it, with Docs/architecture.png as the picture;
    BUILD.md drops the Zigbee plan. The half-time paper goes in Half Time Paper/,
    and Old Flutter App/ becomes old_flutter_app/.
2026-09-24 HANDOFF: one MCU at the start vs XIAO + ESP32, what it would cost
2026-09-29 EspNowLrTest: ESP-NOW long range rig for two ESP32-C3, bench-verified
    Same firmware on both boards, role set by logger.py A|B. A rotates
    LR 250k / LR 500k / 802.11b every 5 s so the modes are compared at the
    same spot; B echoes every packet; one fake t0 per slot, retried until
    acked. logger.py runs on Mac and Windows and writes every line to CSV.
    Bench at 1 m: B receives all three modes at once, one-way 98.5-100 %,
    A-B clock offset IQR 88 us, and B keeps the LR link at 100 % while
    serving a phone over its own AP on the same channel. HANDOFF has the
    numbers; the field test is next.
    [121838_A.csv]
2026-09-29 EspNowLrTest: first field walk, dead between 75 and 100 m; analyse.py
    One walk, 0-125 m, people in between. One-way delivery A->B: 97-100 %
    to 25 m, 48-87 % at 50-75 m (t0 still within 3 tries), 3-11 % at
    100 m, nothing at 125 m. LR250 beats 11b at the same RSSI but every
    mode dies around -92/-94 dBm. The signal is already -53 dBm at 0 m,
    ~30 dB under free space, then falls at free-space slope: the deficit
    is antenna/placement, not distance. HANDOFF has the table and the next
    steps (split the deficit at 25 m, external antenna on B).
    analyse.py joins the two laptops' files through the deterministic
    sequence number and counts delivery against what A sent.
    [125103_A.csv, 125113_B.csv]
2026-09-29 EspNowLrTest: 31 mm wire and a 2 m finish unit take ESP-NOW LR past 100 m
    Two track sessions after the ceramic-antenna walk. With a 31 mm wire
    soldered on each board's antenna: +9 dB at 0 m, LR250 holds 83-97 %
    to 130 m with first-try t0s, dead by 160 m. At 110 m a person crouched
    over A drops LR250 to 17-64 % and t0s to several seconds; raising B to
    ~2 m brings it back to 92.5 % with the phone on B's AP the whole time,
    which also closes the coexistence question at range.
    Today's CSVs are renamed by test (01_bench ... 04_110m-crouched-...),
    indexed in measurements/20260929/README.md; HANDOFF has the tables.
    [01_bench-1m_A.csv, 02_walk-ceramic-antenna_A.csv, 02_walk-ceramic-antenna_B.csv, 03_track-walk-31mm-wire_A.csv, 03_track-walk-31mm-wire_B.csv, 04_110m-crouched-phone-B2m_A.csv, 04_110m-crouched-phone-B2m_B.csv]
2026-09-29 AlgorithmRealTime v5: standalone with a TFT, one button and runs on flash
    A 1.77" ST7735 shows READY, the 3-2-1 countdown, On your marks / Set /
    Go and the result. One button starts, aborts, returns to READY, and a
    3 s hold powers off to System OFF (wake needs the same hold). Every
    start is kept in one of 25 slots on the QSPI flash via nrfx_qspi (the
    mbed core ships no QSPI driver for this board); pull_captures.py pulls
    them as the usual CSVs.
    The display draws from a queue, 300 us after each sample: GAPS went
    from 43 with a pixel budget to 1, the 12 ms detector replay at "set"
    that v4 already had. Also fixes the IMU bus clock: Wire.setClock hit
    the unused D4/D5 bus, the IMU is on Wire1 and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
    [AlgorithmRealTime.ino, Display.h, Storage.h, capture.py, pull_captures.py, verify_rate.py]
2026-09-29 Docs/hardware: display and breadboard photos; HANDOFF wiring as a table
2026-09-29 AlgorithmRealTime: fix first save after boot, dark wake, dated file names
    The first flash save after every boot failed ("NOT saved"): nrfx's
    mem_busy_check reported BUSY for 10 s on a flash that had finished,
    and "free" while it was still erasing. qspiWait now reads the status
    register itself; failures print step, code and address.
    A short press while off now shows nothing: the display starts only
    after the 3 s hold. The PC sends its time on connect and stored runs
    carry it, so files are named date_time_rNNNNN_result.csv (nodate when
    the board was power-cycled without a PC).
    [AlgorithmRealTime.ino, Display.h, Storage.h, capture.py, pull_captures.py]
2026-09-29 AlgorithmRealTime: fix abort hang, 1.5 s power hold with beep, double-press abort
    [AlgorithmRealTime.ino]
2026-10-06 AlgorithmRealTimeESP32: start unit ported to ESP32-C3 SuperMini + BMI270
    Same behaviour as AlgorithmRealTime v5, 800 Hz instead of 833. Own BMI270
    driver with Bosch's config blob, ISR timestamps, LEDC antiphase buzzer,
    runs on an internal flash partition, deep sleep for off. Compiles; not yet
    run on hardware. Wiring and test plan in INFO.md; HANDOFF updated.
    [partitions.csv]
2026-10-07 AlgorithmRealTimeESP32: new pin map, light-sleep off, SPI mode 3
    Pins follow the board layout: buzzer 1/2, LEDA/RES/RS 4/5/6, CS 7,
    SCK 8, button 9, MOSI 10, BMI270 INT1 20 (not 21, the ROM's boot-log TX).
    GPIO9 cannot wake deep sleep, so off is light sleep; an accepted 1.5 s
    hold restarts after the release (GPIO9 held at reset = download mode).
    SCK on GPIO8 shares the blue LED, so the display uses SPI mode 3.
    [AlgorithmRealTimeESP32.ino, Bmi270.h, Display.h, Pins.h]
2026-10-07 AlgorithmRealTimeESP32: samples from the BMI270 FIFO, INT1 only as a clock
    The first block starts lost 63 samples at "set" (the pre-roll replay
    takes ~80 ms, no FPU on the C3) and 3 every 2.000 s to a stall outside
    the sketch; one hole fell on a push-off. Every sample now goes through
    the FIFO (1.28 s of room) and the ISR queues one stamp per edge; each
    frame is paired with its own stamp. A missing stamp is interpolated on
    the sensor's period and counted in DROPPED; an overrun resyncs and shows
    as a gap. The result block prints the worst backlog. Compiles; pairing
    checked in simulation, not yet on hardware.
    [AlgorithmRealTimeESP32.ino, Bmi270.h]
2026-10-07 AlgorithmRealTimeESP32: first block starts (07/10) and the PCB
    Four starts captured by the colleague before the FIFO change: 803.2 Hz,
    0.6 us jitter, 0 dropped, but 14-15 gaps each. Schematic, layout and 3D
    render of the start-unit board.
    [accel_20261007_171733_FS-0.455s.csv, accel_20261007_171818_0.268s.csv, accel_20261007_171858_0.171s.csv, accel_20261007_173110_0.245s.csv]
2026-10-07 AlgorithmRealTime: 25 XIAO block starts from 07/10, two bench runs from 29/09
    Pulled from the board's flash (no date: run on a power bank). Same rate,
    jitter and single gap at "set" as the Python-era captures; the board's
    verdicts match start_detector.py within ~1 ms.
    [nodate_r00012_0.174s.csv, nodate_r00013_0.156s.csv, nodate_r00014_0.298s.csv, nodate_r00015_0.558s.csv, nodate_r00016_0.172s.csv, nodate_r00017_0.186s.csv, nodate_r00018_0.206s.csv, nodate_r00019_0.156s.csv]
2026-10-07 AlgorithmRealTimeESP32: BMI270 init as on the colleague's working board, no bus recovery, per-step log
2026-10-07 HANDOFF: 07/10 ESP32 block starts, FIFO sampling, BMI270 init from the colleague's board
2026-10-08 AlgorithmRealTimeESP32: first FIFO block starts (08/10), no gaps, 803.6 Hz; HANDOFF
    [accel_20261008_010815_0.177s.csv, accel_20261008_010908_0.164s.csv]
